Mozzie-AU/LeafOBC-WafflePlate/hardware/README.md

# Hardware

- `original-module/`: KiCad schematic of the original waffle plate, reverse-engineered. See [docs/schematic-notes.md](../docs/schematic-notes.md).
- `replica-altium/`: Angel Monera Martinez's Altium replica design (built, untested). See its [README](replica-altium/README.md).
