Mozzie-AU/LeafOBC-WafflePlate/docs/full-bridge-gate-drive.md

# Primary full bridge: gate network

Work in progress on the gate-drive network around the eight full-bridge IGBTs (section C of the schematic). Everything here comes from **copper traced in the stitched image** of the laser-stripped module. On that module every semiconductor is shorted, resistors are open and the capacitors are degraded. So:

- **Connections** can be confirmed with a meter, but only between copper points that no part bridges.
- **Part values and types** can't be measured on this module. They are listed from references until a second unit is available.

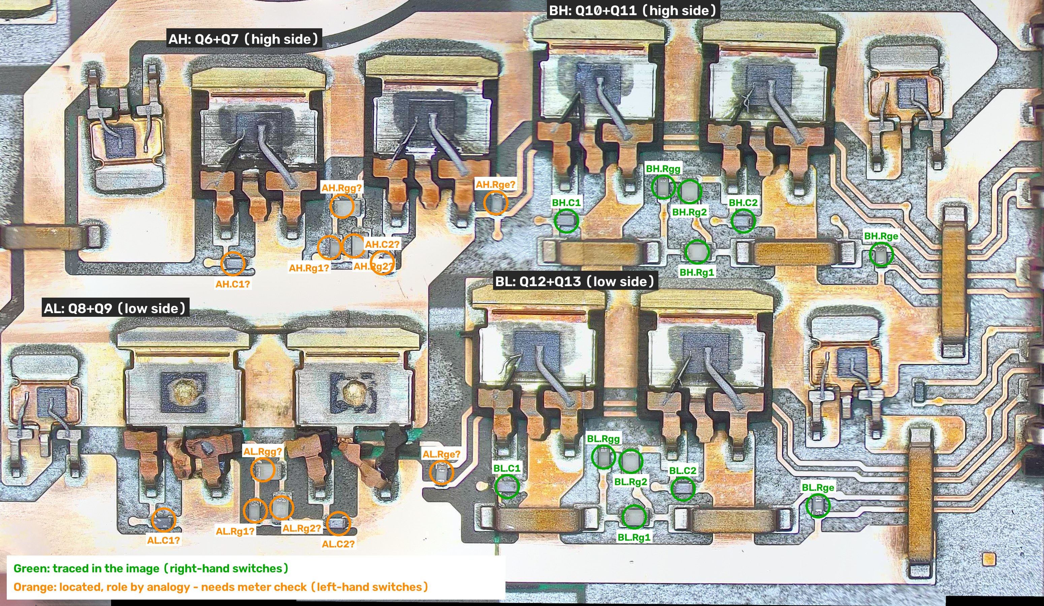
[picture p4: images/annotated/full-bridge-gate-map.jpg]
Full-bridge gate network map


*Crop of [`images/stitched/waffle-plate-top.jpg`](../images/stitched/waffle-plate-top.jpg), x 1850–4950, y 2950–4750. Green circles are parts whose connections were traced in the image. Orange circles are parts located but assigned by analogy, so they need a meter check.*

## Switches and legs

Read from where the IGBT tabs (collectors) and emitter leads sit on the copper:

| Switch | IGBTs | Collector (tab) on | Emitter on | Freewheel diode |
|---|---|---|---|---|
| **AH**: leg A high side | Q6, Q7 (top-left) | top HV_BUS+ copper | leg A midpoint (large cream area, left) | D7 |
| **AL**: leg A low side | Q8, Q9 (bottom-left) | leg A midpoint | bottom rail (HB_N) | D8 |
| **BH**: leg B high side | Q10, Q11 (top-right) | top HV_BUS+ copper | leg B midpoint (vertical copper column) | D9 |
| **BL**: leg B low side | Q12, Q13 (bottom-right) | leg B midpoint | bottom rail (HB_N) | D10 |

This matches the provisional assignment already in the schematic.

On each IGBT, the **left** lead has the thin bond wire (**gate**). The **right** lead has the thick bond wire (**emitter**). The middle lead is trimmed, because the collector is the tab.

The freewheel diodes have bond wires to **both** outer leads, so both outer leads are the anode, and the tab is the cathode.

## Gate network per switch

The two right-hand switches (BH, BL) have identical copper layouts, one shifted about 800 px below the other. Both were traced in full. Each has six small parts:

| Part | Connects | Role | Ukrainian schematic | Reference value |
|---|---|---|---|---|
| **Rg1** | drive input ↔ gate of IGBT 1 (via the left jumper) | gate resistor | R210 | 10 Ω |
| **Rg2** | drive input ↔ gate of IGBT 2 | gate resistor | R212 | 10 Ω |
| **Rgg** | gate 1 ↔ gate 2 | resistor between the two gates | R211 | 10 Ω |
| **C1** | gate 1 ↔ emitter (beside the gate lead) | gate–emitter capacitor | C210 | 1 nF |
| **C2** | gate 2 ↔ emitter | gate–emitter capacitor | C211 | 1 nF |
| **Rge** | drive input ↔ emitter rail; a second track from the same end runs to the module pins | drive-input pull-down; emitter (Kelvin) return | R213 | 1 kΩ |

```
 drive in (pad) ──┬──[Rg1]──┬── gate IGBT1 ──[C1]── emitter
                  │       [Rgg]
                  ├──[Rg2]──┴── gate IGBT2 ──[C2]── emitter
                  └──[Rge]────────────────────────── emitter ──→ Kelvin return (pad)
```

This reproduces the Ukrainian schematic exactly, including its unusual 10 Ω between the gates. That's now confirmed by the copper, not just the drawing.

The roles of C1/C2 versus Rge come from where they connect. On this module the parts can't tell us whether a given chip is a resistor or a capacitor. The values in the table are the Ukrainian schematic's and are **unconfirmed**.

### Layout notes

- The gate-drive input and the far-side gate cross the big copper (the midpoint column, or the emitter copper) on the **horizontal copper jumpers** at y ≈ 3700 (BH) and y ≈ 4490 (BL).
- The drive-input and Kelvin-return tracks run right, **under the vertical jumpers** at x ≈ 4570–4650, to the module pins on the right edge.
- Each gate node has a small round test pad: BH at (3445, 3600) and (3977, 3606); BL at the corresponding spots.

## Part positions

Pixel positions in the stitched image.

| Switch | Rg1 | Rg2 | Rgg | C1 | C2 | Rge |
|---|---|---|---|---|---|---|
| BH (traced) | (3920, 3698) | (3898, 3519) | (3820, 3505) | (3532, 3606) | (4057, 3606) | (4467, 3705) |
| BL (traced) | (3733, 4485) | (3723, 4320) | (3642, 4307) | (3356, 4395) | (3878, 4402) | (4279, 4452) |
| AH (by analogy) | (2828, 3685)? | (2900, 3680)? | (2865, 3562)? | (2541, 3733)? | (2985, 3730)? | (3322, 3552)? |
| AL (by analogy) | (2608, 4467)? | (2686, 4458)? | (2630, 4345)? | (2336, 4494)? | (2855, 4505)? | (3161, 4353)? |

For the left-hand switches, what the image does show:

- **AH:** C1 sits beside Q6's gate lead and C2 beside Q7's. The two "Rg" parts share a bottom track (the drive input), and Rgg joins their tops.
- **AL:** the parts sit in the same pattern.

Which gate each Rg feeds hasn't been traced yet.

## Damage

- **AL (Q8, Q9) failed and ruptured.** Their leads and "pigtails" are burnt and partly melted, with green residue next to Q9, and the two dies show a round spot in the middle. Their lead shapes **don't represent the real die structure**, so don't use them to identify gate or emitter.
- **Some gate terminations on the other dies were damaged** during handling. The gate/emitter identification (thin bond wire to the left lead = gate, thick to the right = emitter) is consistent across the dies that are intact, and agrees with both the Ukrainian schematic and Angel's design. Still, treat any single die's bond wires with care.

## Comparison with Angel's replica design

Angel's `igbt pair` sub-sheet (in [`hardware/replica-altium/kicad/`](../hardware/replica-altium/kicad/)) has **exactly the traced topology** for each of the four switches:

| Traced role | Angel's part | Value |
|---|---|---|
| Rg1: drive → gate 1 | R10 | 10 Ω |
| Rg2: drive → gate 2 | R12 | 10 Ω |
| Rgg: gate 1 ↔ gate 2 | R11 | 10 Ω |
| C1: gate 1 → emitter | C3 | 1 nF |
| C2: gate 2 → emitter | C2 | 1 nF |
| Rge: drive → emitter | R13 | 1 kΩ |

So three sources agree on the **topology**: the copper, the Ukrainian schematic and Angel's design. They aren't independent sources for the **values**, because Angel's values match the Ukrainian schematic and were probably taken from it.

(Angel's PFC driver had the transistors' emitter and collector swapped; see [PFC gate driver](pfc-gate-driver.md). His full-bridge gate network doesn't have that problem.)

## Are the values reasonable? (datasheet check)

There is **no public RJP6012 datasheet**. Renesas has said all its IGBTs are end-of-life ([Renesas community thread](https://community.renesas.com/power-products/f/power-management/58643/rjp6012-datasheet)). As a stand-in, the [RJP60V0DPM](https://www.mouser.com/datasheet/2/698/r07ds0669ej0200_rjp60v0dpm-1093090.pdf) is a 600 V, 22 A Renesas IGBT from the same RJP60 family. For Angel's part, the [HGTG10N120BND](https://www.mikrocontroller.net/attachment/132171/10n120bnd.pdf) datasheet covers the same 1200 V NPT IGBT as the HGT1S10N120BNS, plus an internal diode.

| | RJP60V0DPM | HGTG10N120BND |
|---|---|---|
| V(GE) max | ±30 V | ±20 V (±30 V pulsed) |
| Cies | 1080 pF | not stated |
| Qg at 15 V | 75 nC | 100 nC |
| Switching test R(G) | 5 Ω | 10 Ω |
| t(f) | 70 ns | 100–140 ns |

Against those figures:

- **10 Ω per gate (Rg1, Rg2):** the same order as the datasheet test resistors (5–10 Ω). Reasonable.
- **1 nF gate–emitter (C1, C2):** about the same as the IGBT's own input capacitance (~1.1 nF), so it roughly doubles the gate load. With 10 Ω the gate time constant is about 20 ns. That slightly slows the switching edges and reduces Miller-induced turn-on (Cres is only ~42 pF). It adds about 15 nC per IGBT at 15 V, roughly +20 % driver load. Reasonable for a few-tens-of-kHz bridge.
- **10 Ω between the two gates (Rgg):** unusual. With separate gate resistors already present, it looks intended to tie the two paralleled gates together and damp oscillation between them. It's harmless at this value.
- **1 kΩ drive-input pull-down (Rge):** a normal value for holding the gates off when the driver is unpowered.
- **Gate drive voltage:** set by the charger board's gate driver and **not yet known**. It must stay within V(GE) max, and Angel's part has the tighter rating (±20 V).

**For a replica:** Angel's HGT1S10N120BNS is a 1200 V NPT IGBT with higher gate charge (100 nC against 75 nC) and a slower fall time. It's over-rated for a ~400 V bus, and it will run with more switching loss than a 600–650 V part. Worth comparing with current 600–650 V IGBTs before committing.

## Gate-drive pads

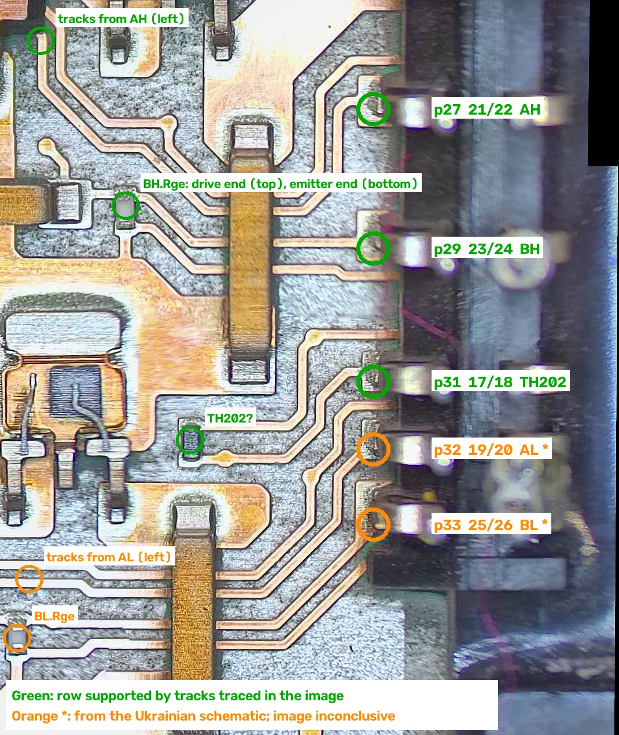
[picture p5: images/annotated/gate-drive-pads.jpg]
Gate-drive pad rows on the right edge


*Crop of the stitched image, x 4250–5320, y 3350–4620. Circles on the right mark the module-side pad of each pin row.*

The lower right edge has seven pin rows. Each row has an **inner** pin, whose pad the tracks reach, and an **outer** pin. That fits the draft and the Ukrainian schematic naming each pad as a pin pair ("21/22" and so on). From top to bottom the rows match the draft's pads in order: p23 (T1), p25 (T4), p27, p29, p31, p32, p33.

Each switch's two tracks (drive input and emitter return) run as a pair to one row:

| Row (y) | Draft pad | Pins | Switch | Drive pin | Emitter (Kelvin) pin | Evidence |
|---|---|---|---|---|---|---|
| 3538 | p27 | 21/22 | **AH** | 22 | 21 (BR_A) | Image: the pair of tracks from the left-hand switches lands on this row |
| 3779 | p29 | 23/24 | **BH** | 23 | 24 (BR_B) | Image: the DRV_BH track lands on the inner pad. The emitter track from BH.Rge runs to the same row |
| 4009 | p31 | 17/18 | — | — | — | Image: a small chip at (4578, 4110) sits across this row's two pins. This is TH202, the 100 k thermistor on the Ukrainian schematic |
| 4126 | p32 | 19/20 | **AL** \* | 19 | 20 (HB_N) | Ukrainian schematic only |
| 4256 | p33 | 25/26 | **BL** \* | 25 | 26 (HB_N) | Ukrainian schematic only |

\* For the bottom two rows, the AL and BL track pairs run under the lower vertical jumper and cross on their way up to the pins. In the image I couldn't tell which row each pair reaches, so these two follow the Ukrainian schematic.

**Which pin in each pair is drive** is taken from the Ukrainian schematic. The image confirms it for BH only, where the drive track lands on the inner pad. The physical numbering (which of the inner and outer pins is the lower number) isn't known yet.

The two upper rows, p23 (T1) and p25 (T4), are the bridge midpoints to the transformers. Which leg goes to which is still listed as check 5 below.

## Meter checks (copper only)

Probe copper on both sides, never across a part.

1. **BH and BL:** gate test pad ↔ gate lead pad, for each IGBT, to confirm the gate nets.
2. **BH and BL:** each end of the horizontal jumpers ↔ the tracks they join (left end to gate 1, right end to the drive input).
3. **Pad mapping:** confirm the table above. For each switch, continuity from the Rge drive-input end and its emitter (Kelvin) track to the inner and outer pin of its row. AL and BL (p32, p33) need it most.
4. **AH and AL:** for each part, check each end against the gate pads, the emitter copper and the shared drive-input track, to confirm or correct the roles marked "?".
5. **Midpoints:** leg A midpoint (cream area) ↔ pad p23 (T1); leg B midpoint (vertical column) ↔ pad p25 (T4). Or the other way round, which is the point of checking.

## Still needed

- A second, intact module to measure the part values and confirm the part types.
- Confirmation of the pad mapping, especially AL/BL (check 3).
- Confirmation of the left-hand switches (check 4).
- The gate drive voltage from the charger board.

## In the schematic

Section C of [`waffle-plate.kicad_sch`](../hardware/original-module/waffle-plate.kicad_sch) is drawn wired as an H-bridge. Leg A (AH above AL) and leg B (BH above BL) share the HV_BUS+ rail across the top. Each leg's midpoint is a wire (BR_A, BR_B), and the two bottom rails join as HB_N. Each switch's gate network runs from its drive pad to both gates, with its emitter (Kelvin) pad on the emitter rail. Everything in section C is marked `Verified = no`. The parts are:

- **AH:** R11–R14, C11–C12.
- **AL:** R21–R24, C21–C22.
- **BH:** R31–R34, C31–C32.
- **BL:** R41–R44, C41–C42.

Values ending in "?" are the reference values. Each switch has its own drive-input net (`DRV_AH` and so on) and its own gate nets (`G_AH1`, `G_AH2` and so on). Each switch's drive and emitter pads are drawn next to it (P26–P33), marked unconfirmed, with the source noted on each.
