Mozzie-AU/LeafOBC-WafflePlate/hardware/replica-altium/fabrication/2024-10-28-jlcpcb/Report Board Stack/waffle.xls

Board Stack Report
Stack Up |  | Layer Stack
Layer | Board Layer Stack | Name | Material | Thickness | Constant
1 |  | Top Overlay |  | 0mm
2 |  | Top Solder | SM-001 | 0.0254mm | 4
3 |  | Top Surface Finish | PbSn | 0.02mm
4 |  | Top Layer | CF-004 | 0.035mm
5 |  | Dielectric 1 | Core-043 | 1.5mm | 4.3
6 |  | Bottom Layer | CF-004 | 0.035mm
7 |  | Bottom Surface Finish | PbSn | 0.02mm
8 |  | Bottom Solder | SM-001 | 0.0254mm | 4
9 |  | Bottom Overlay |  | 0mm
 | Height : 1.6608mm
