Mozzie-AU/LeafOBC-WafflePlate/images/raw/waffle-plate-top/IMG00000.JPG

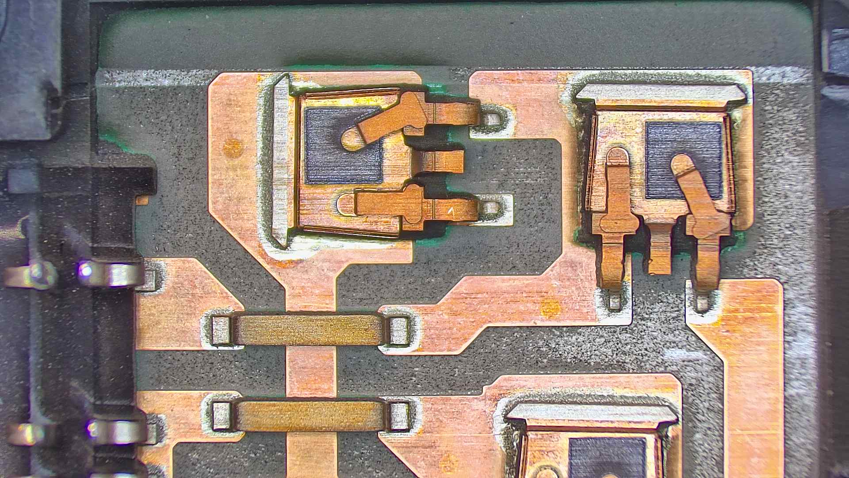
images/raw/waffle-plate-top/IMG00000.JPG
