Mozzie-AU/LeafOBC-WafflePlate/images/raw/waffle-plate-top/IMG00001.JPG

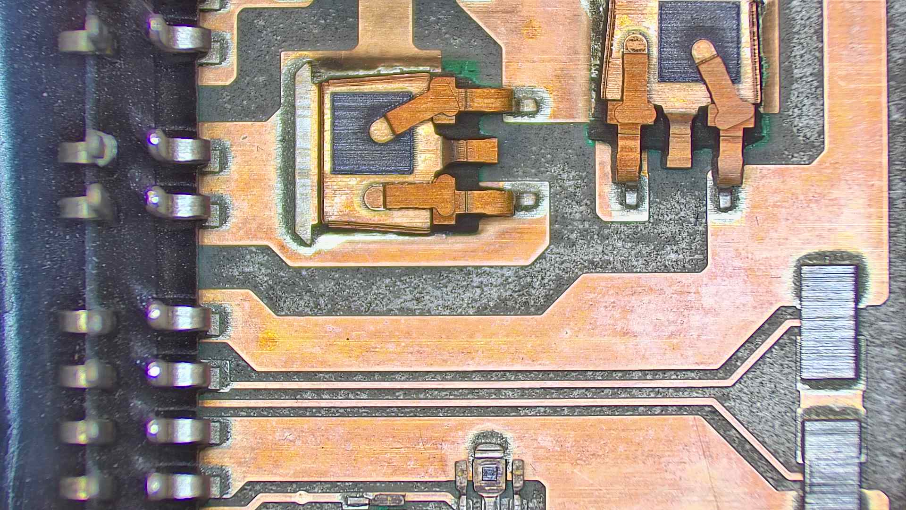
images/raw/waffle-plate-top/IMG00001.JPG
