Mozzie-AU/LeafOBC-WafflePlate/images/raw/waffle-plate-top/IMG00002.JPG

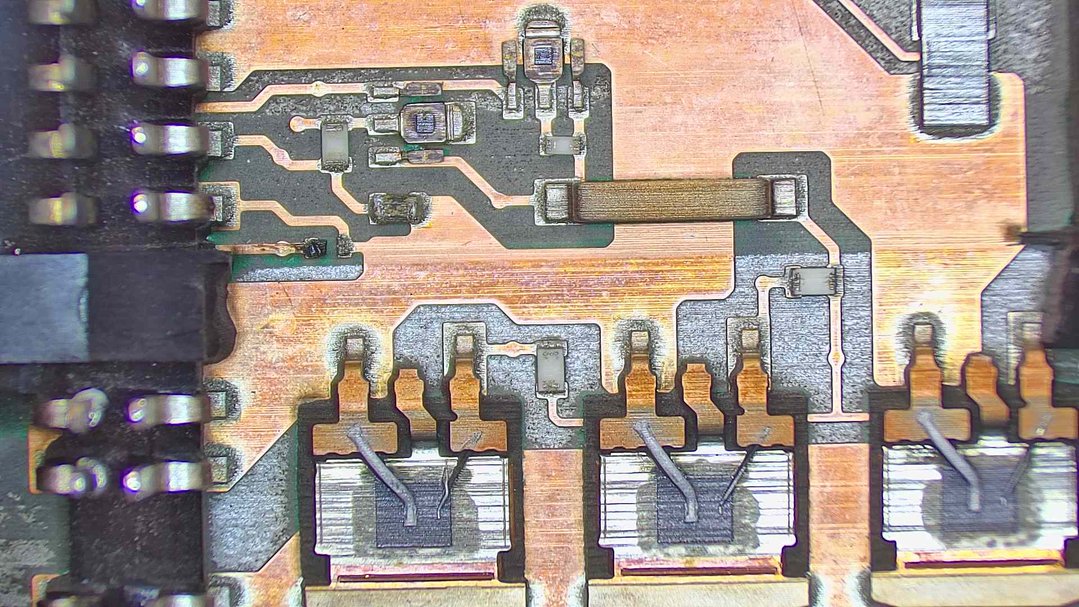
images/raw/waffle-plate-top/IMG00002.JPG
