Mozzie-AU/LeafOBC-WafflePlate/images/raw/waffle-plate-top/IMG00003.JPG

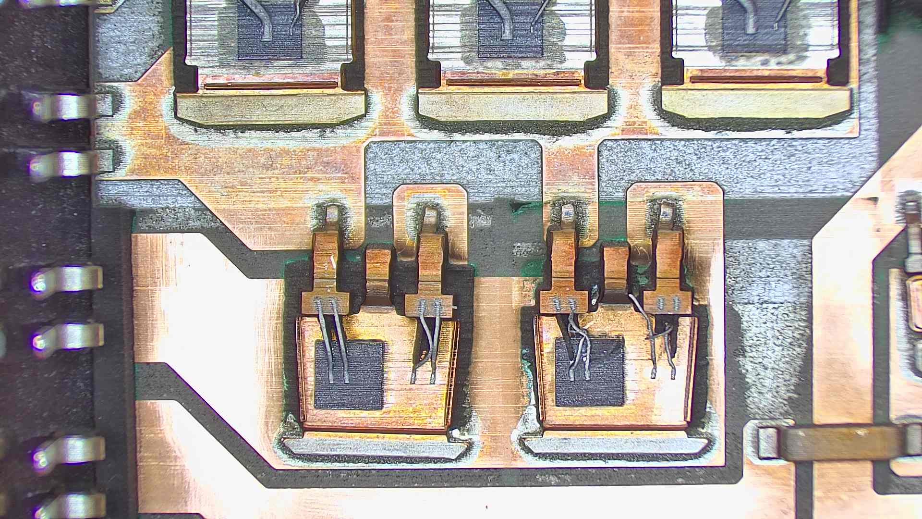
images/raw/waffle-plate-top/IMG00003.JPG
