Mozzie-AU/LeafOBC-WafflePlate/images/raw/waffle-plate-top/IMG00004.JPG

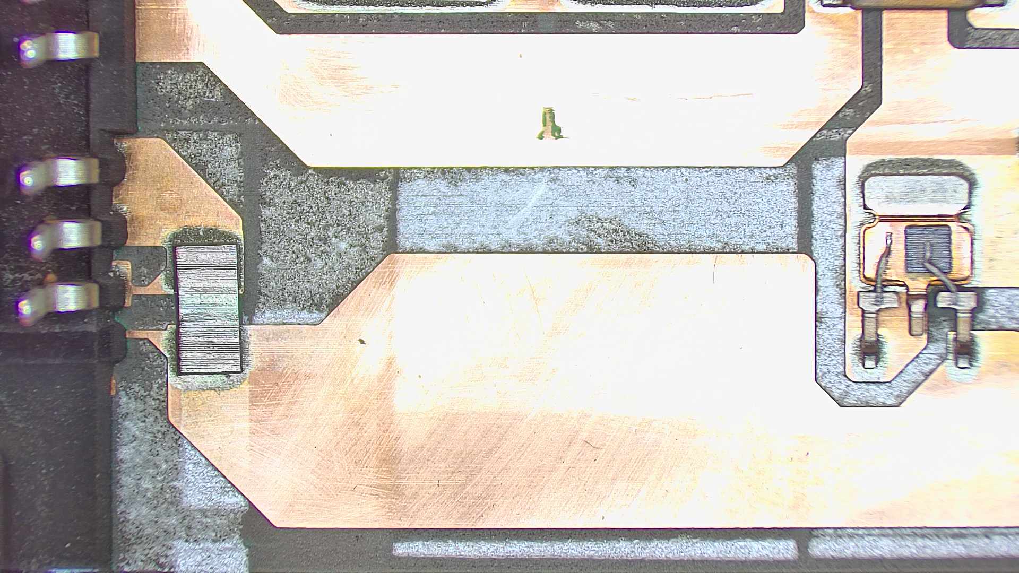
images/raw/waffle-plate-top/IMG00004.JPG
