Mozzie-AU/LeafOBC-WafflePlate/images/raw/waffle-plate-top/IMG00005.JPG

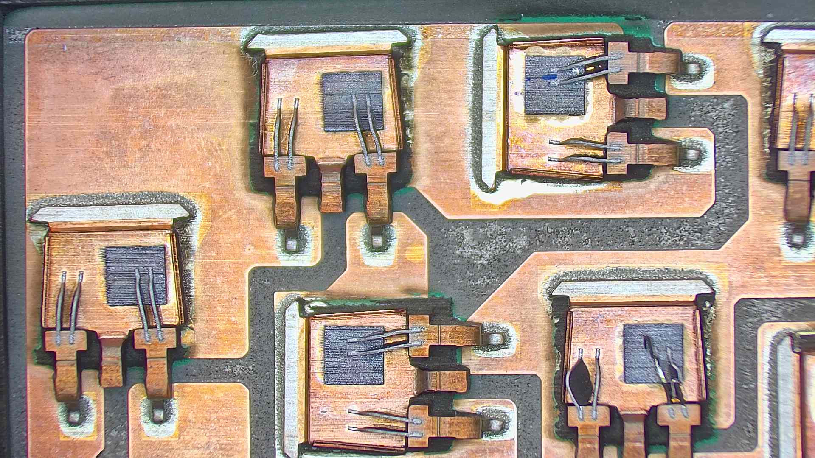
images/raw/waffle-plate-top/IMG00005.JPG
