Mozzie-AU/LeafOBC-WafflePlate/images/raw/waffle-plate-top/IMG00006.JPG

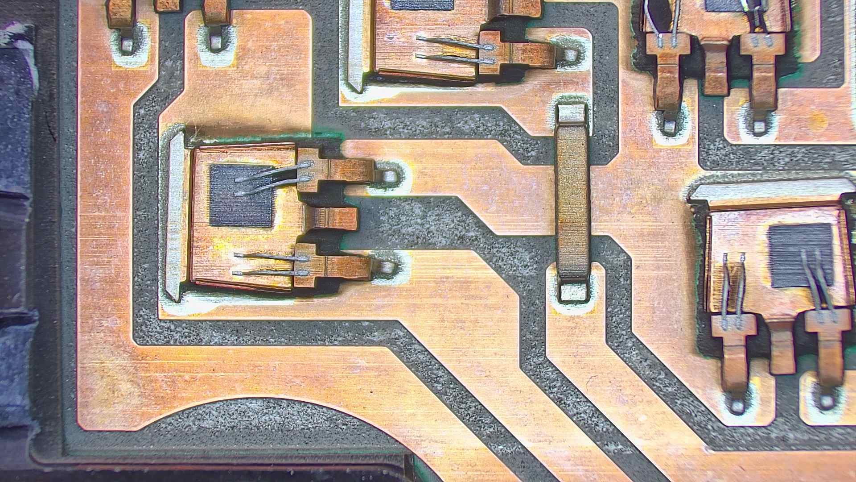
images/raw/waffle-plate-top/IMG00006.JPG
