Mozzie-AU/LeafOBC-WafflePlate/images/raw/waffle-plate-top/IMG00007.JPG

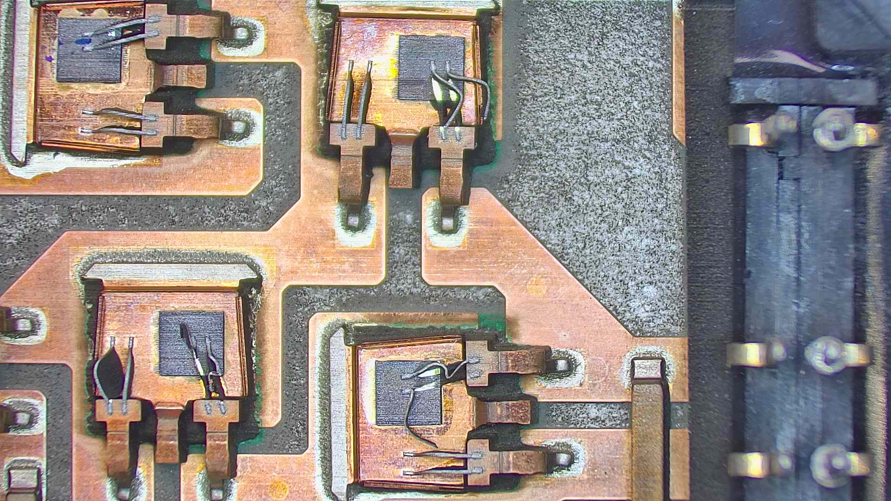
images/raw/waffle-plate-top/IMG00007.JPG
