Mozzie-AU/LeafOBC-WafflePlate/images/raw/waffle-plate-top/IMG00008.JPG

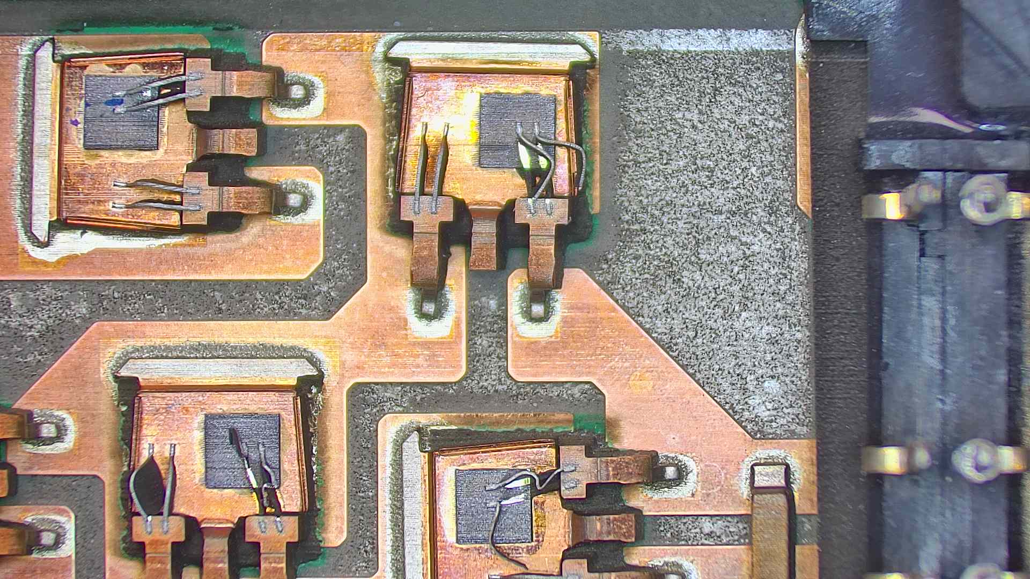
images/raw/waffle-plate-top/IMG00008.JPG
