Mozzie-AU/LeafOBC-WafflePlate/images/raw/waffle-plate-top/IMG00009.JPG

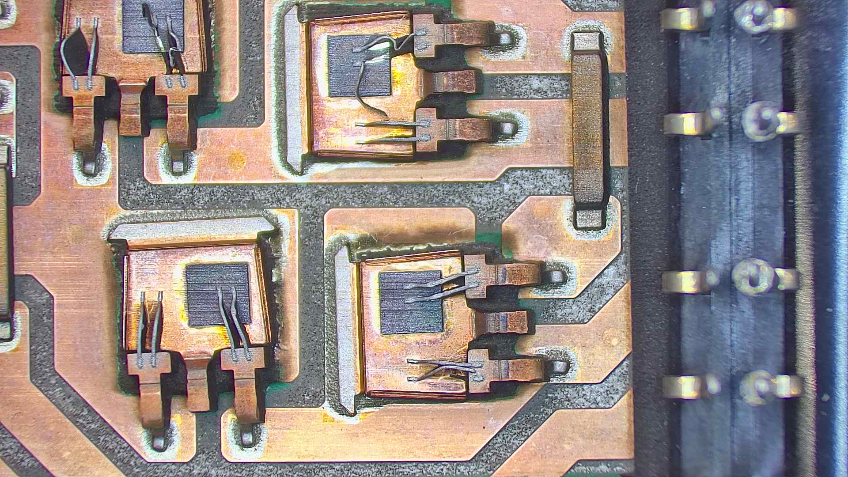
images/raw/waffle-plate-top/IMG00009.JPG
