Mozzie-AU/LeafOBC-WafflePlate/images/raw/waffle-plate-top/IMG00010.JPG

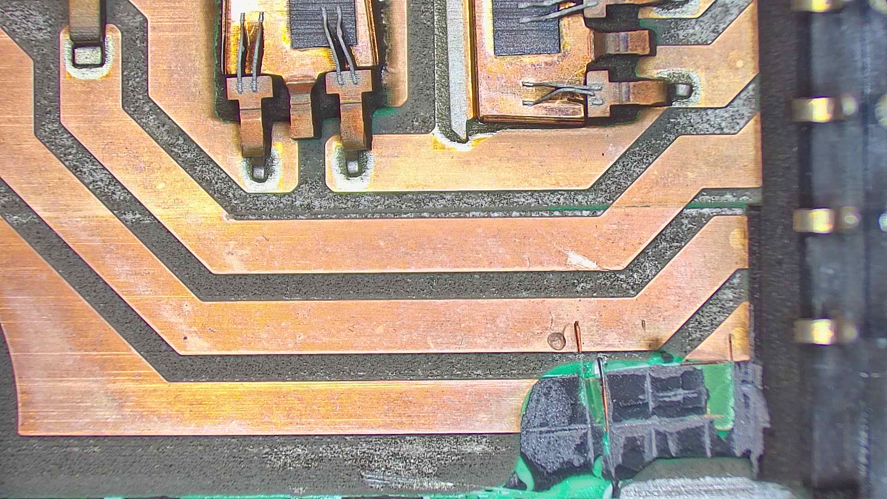
images/raw/waffle-plate-top/IMG00010.JPG
