Mozzie-AU/LeafOBC-WafflePlate/images/raw/waffle-plate-top/IMG00011.JPG

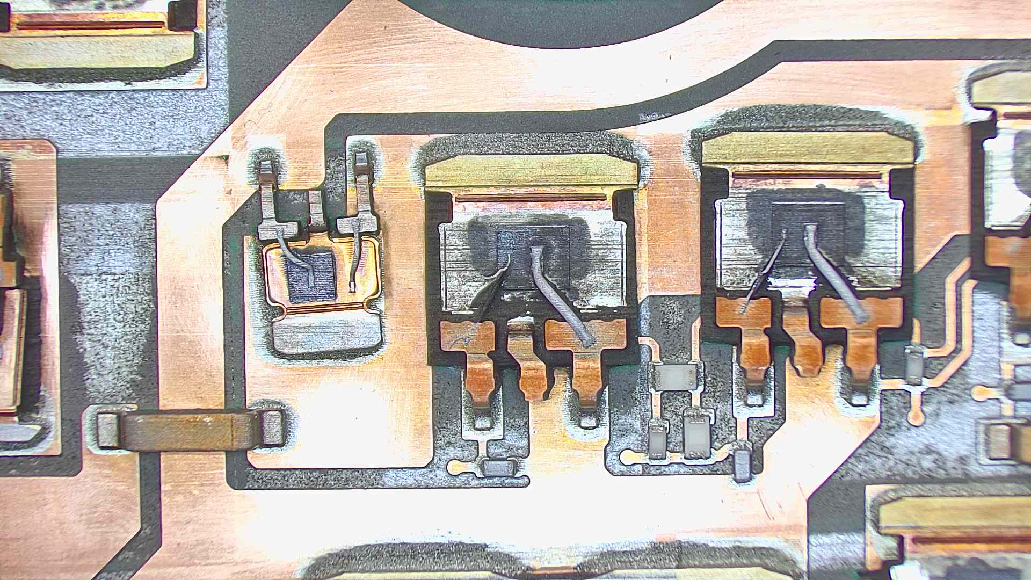
images/raw/waffle-plate-top/IMG00011.JPG
