Mozzie-AU/LeafOBC-WafflePlate/images/raw/waffle-plate-top/IMG00012.JPG

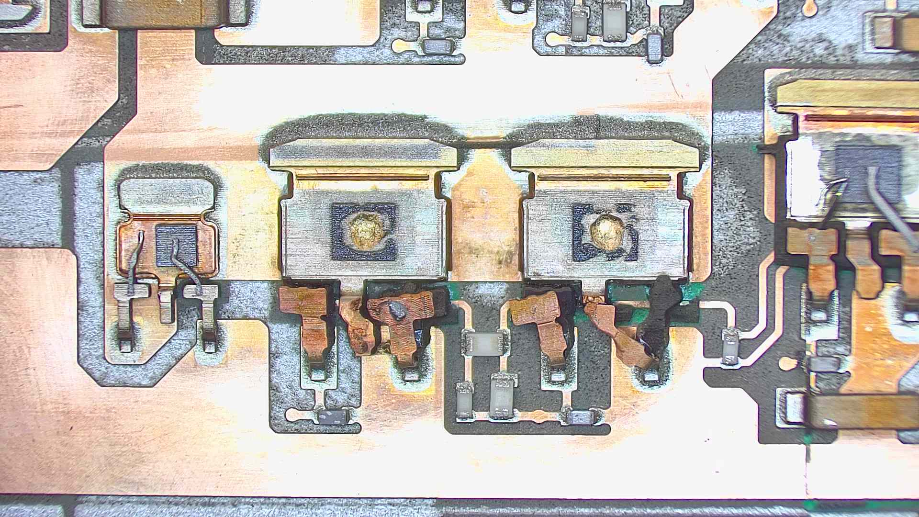
images/raw/waffle-plate-top/IMG00012.JPG
