Mozzie-AU/LeafOBC-WafflePlate/images/raw/waffle-plate-top/IMG00013.JPG

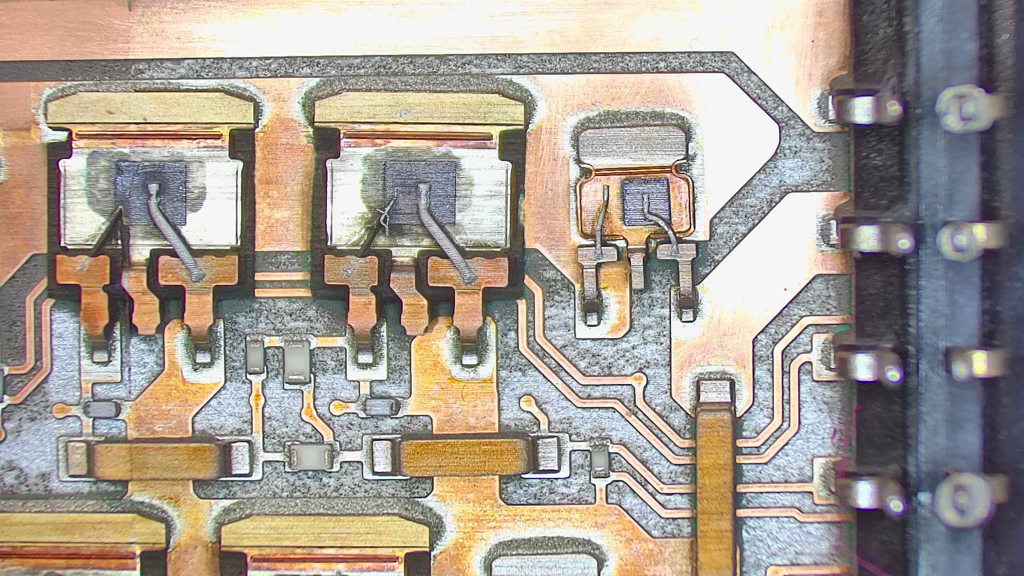
images/raw/waffle-plate-top/IMG00013.JPG
