Mozzie-AU/LeafOBC-WafflePlate/images/raw/waffle-plate-top/IMG00014.JPG

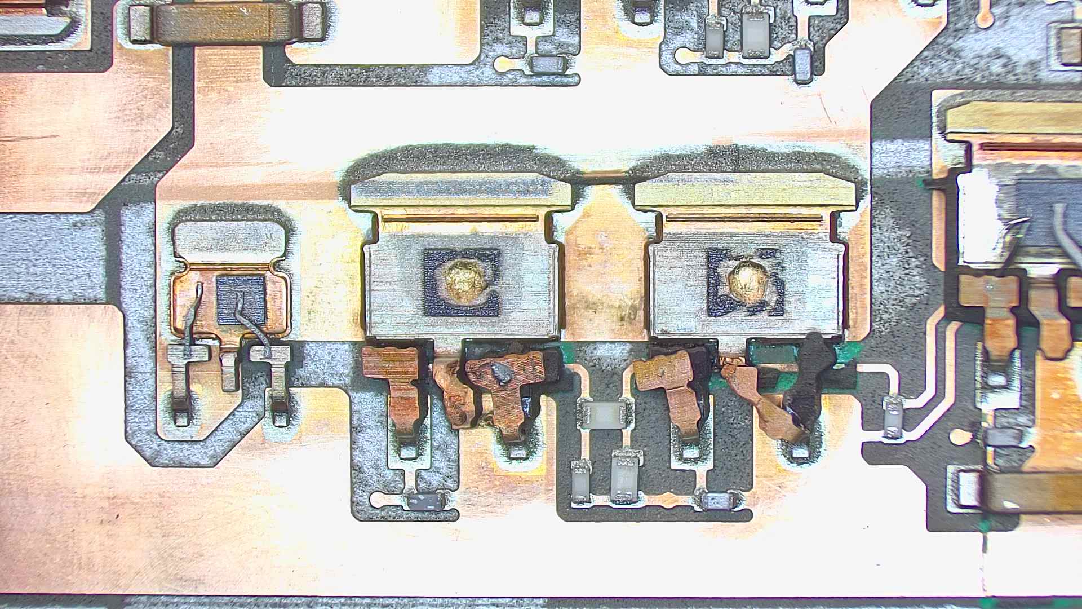
images/raw/waffle-plate-top/IMG00014.JPG
