Mozzie-AU/LeafOBC-WafflePlate/images/raw/waffle-plate-top/IMG00015.JPG

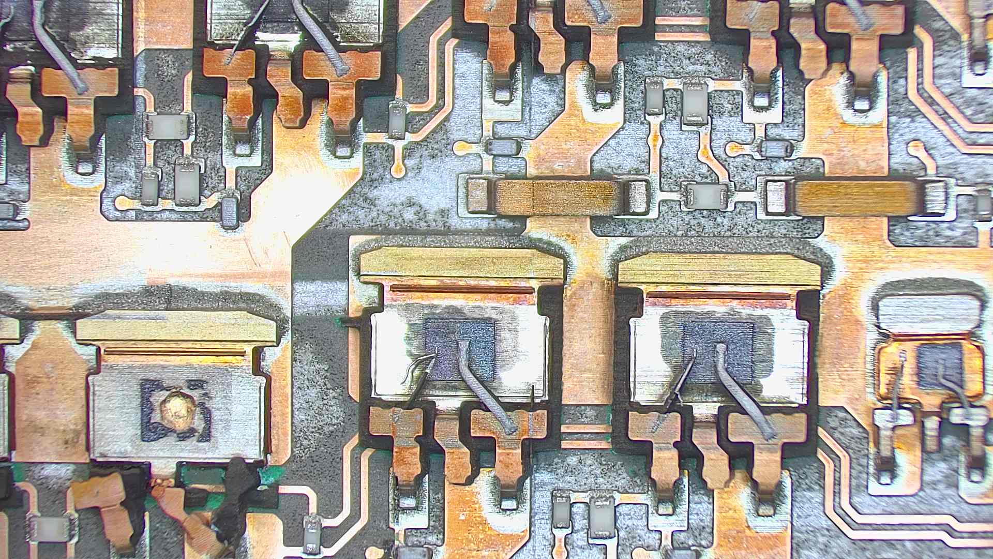
images/raw/waffle-plate-top/IMG00015.JPG
