Mozzie-AU/LeafOBC-WafflePlate/images/raw/waffle-plate-top/IMG00016.JPG

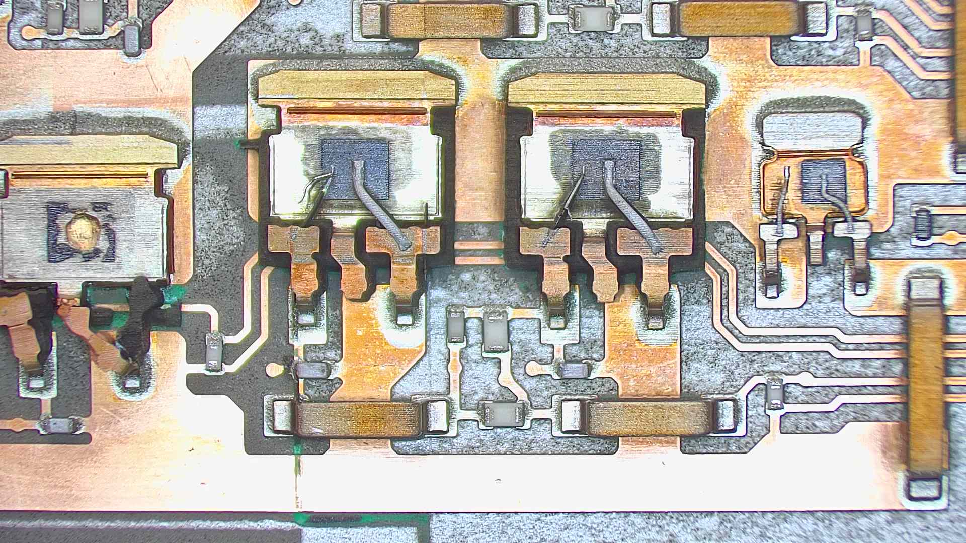
images/raw/waffle-plate-top/IMG00016.JPG
