Mozzie-AU/LeafOBC-WafflePlate/images/raw/waffle-plate-top/IMG00017.JPG

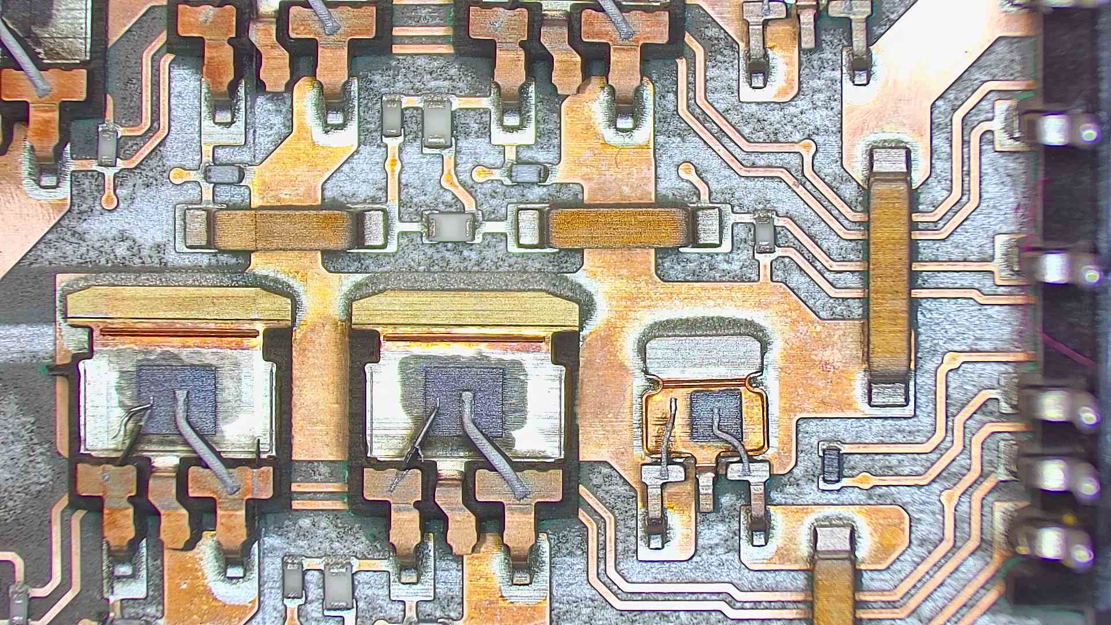
images/raw/waffle-plate-top/IMG00017.JPG
