Mozzie-AU/LeafOBC-WafflePlate/images/raw/waffle-plate-top/IMG00018.JPG

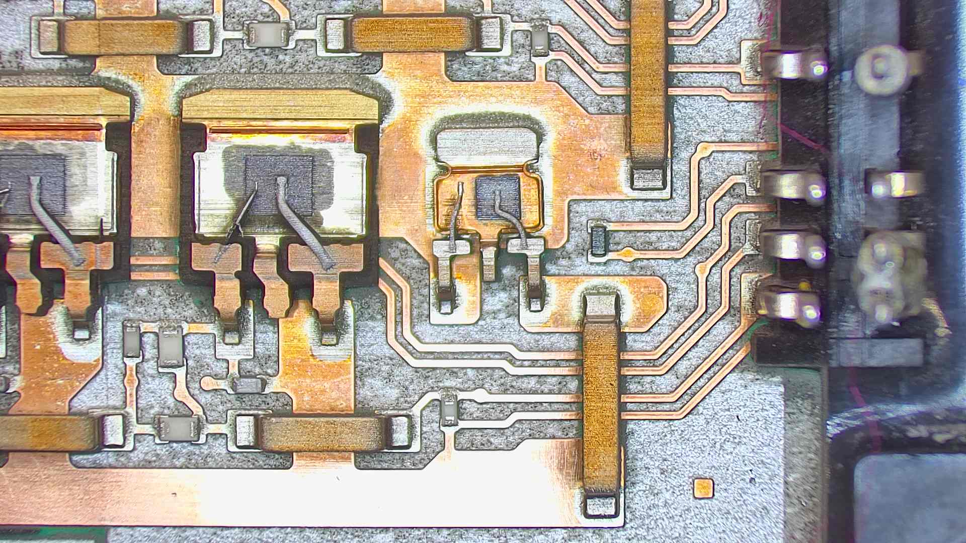
images/raw/waffle-plate-top/IMG00018.JPG
