Mozzie-AU/LeafOBC-WafflePlate/images/raw/waffle-plate-top/IMG00019.JPG

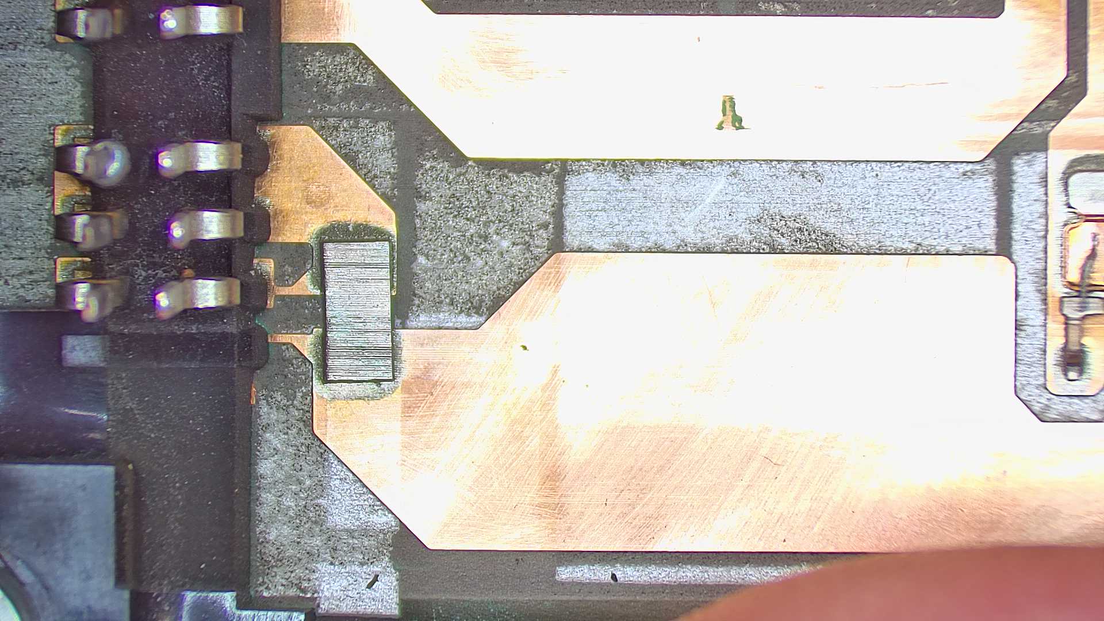
images/raw/waffle-plate-top/IMG00019.JPG
