Mozzie-AU/LeafOBC-WafflePlate/images/raw/waffle-plate-top/IMG00020.JPG

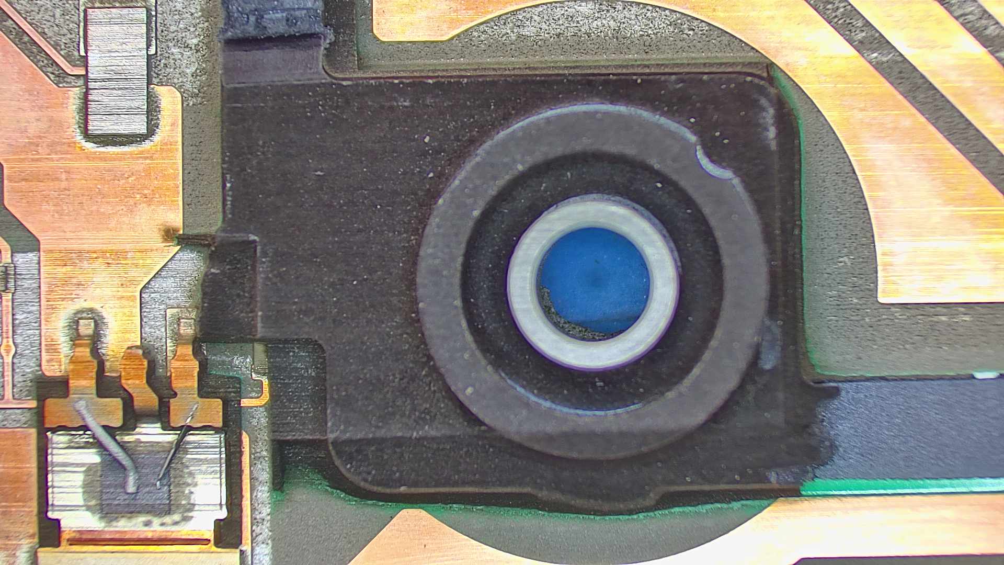
images/raw/waffle-plate-top/IMG00020.JPG
