Mozzie-AU/LeafOBC-WafflePlate/docs/component-inventory.md

# Component inventory

One row per component. Reference designators are assigned in this project; the original has none visible. Coordinates are pixel positions (x, y) in [`images/stitched/waffle-plate-top.jpg`](../images/stitched/waffle-plate-top.jpg).

| Ref | Region | Type (guess) | Markings | Position (px) | Notes |
|---|---|---|---|---|---|
| Q1 | Upper left | | | | |
| Q2 | Upper left | | | | |

## Conventions

- `Q` = transistor die, `D` = diode die, `R`/`C` = passives, `J` = connector pin, `L` = bridging link
- Number regions in this order: top-left, middle-left, lower-left, upper-right, lower-right. Within each region, number left to right, then top to bottom.
