Mozzie-AU/LeafOBC-WafflePlate/hardware/replica-altium/fabrication/2024-10-28-jlcpcb/BOM/Bill of Materials-Nissan Leaf Waffle.xlsx

Comment | Designator | Footprint | Description | Quantity | Supplier 1 | Supplier Part Number 1
1uF | C1 | 1206 | 1206 1UF 50V | 1
1nF | C2NE, C2NW, C2SE, C2SW, C3NE, C3NW, C3SE, C3SW | 1206 | CAPACITOR 1nF 1206 | 8
SE20DLJ-M3/I | D1, D2, D3, D4, D5, D6, D7, D8, D9, D10, D11, D12, D13, D14, D15, D16, D17NE, D17NW, D17SE, D17SW | PG-TO252-3 - diode | Diode rectifier 1V/1A/700V, SE20DLJ-M3/I | 20 | Digikey, Mouser | 112-VS-E5TX3012S2L-M3CT-ND, 78-VS-E5TX3012S2L-M3
connector_waffle | J1 | waffle |  | 1
BCX53-16 | Q1 | SOT-89 | BCX53-16 PNP | 1 | Mouser | 726-BCX5316H6327XTSA
BCX56-16 | Q2 | SOT-89 | BCX56-16 NPN | 1 | Mouser | 726-BCX5616H6327XTSA
HGT1S10N120BNST | Q3, Q4, Q5, Q6NE, Q6NW, Q6SE, Q6SW, Q7NE, Q7NW, Q7SE, Q7SW | PG-TO252-3 | IGBT N type 20A(40) 600V dpakpossible replacement STB27NM60ND FGB20N60SF RJP6012, HGT1S10N120BNST IGBT N type 20A(40) 600V dpakpossible replacement STB27NM60ND FGB20N60SF RJP6012 | 11 | Rs | 8076660P
1mOHM | R1, R9 | 1206 | resistor 1206 1mohm. | 2
10K | R2 | 1206 | resistor 10K 1206 | 1
43R | R3 | 1206 | resistor 43R 1206 | 1
NB20N50104JBA | R4, R8 | 1206 | NB20N50104JBA: resistor NTC 100K | 2
39R | R5, R6, R7 | 1206 | resistor 39R 1206 | 3
10R | R10NE, R10NW, R10SE, R10SW, R11NE, R11NW, R11SE, R11SW, R12NE, R12NW, R12SE, R12SW | 1206 | resistor | 12
1K | R13NE, R13NW, R13SE, R13SW | 1206 | resistor 1k 1206 | 4
