Mozzie-AU/LeafOBC-WafflePlate/hardware/replica-altium/kicad/ALTIUM_EMBEDDED_MODELS/p204_SOT-89.stp

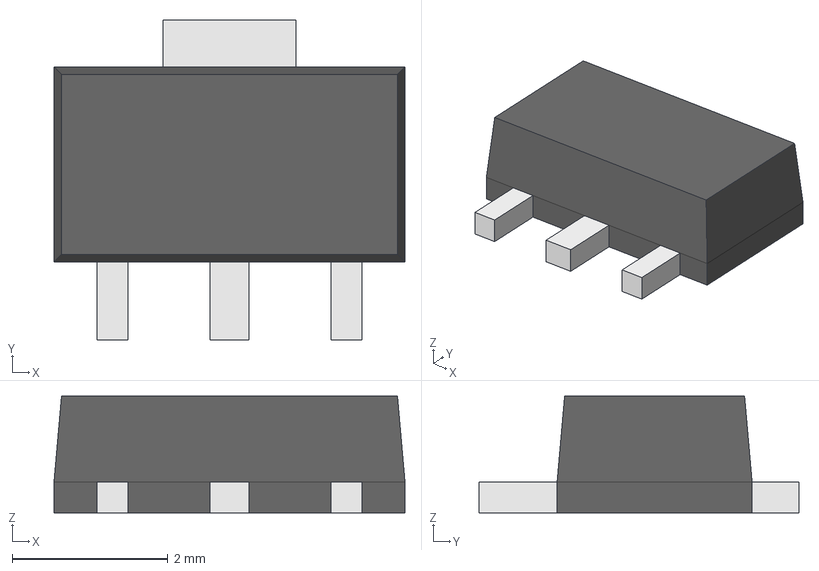
[picture p35: CAD file, 2026-10-25]
hardware/replica-altium/kicad/ALTIUM_EMBEDDED_MODELS/p204_SOT-89.stp
4.50 x 4.10 x 1.50 mm
