Mozzie-AU/LeafOBC-WafflePlate/hardware/replica-altium/fabrication/2024-10-28-jlcpcb/DRC/waffle.html

Altium

# Design Rule Verification Report

Date: | | 2024-10-27
Time: | | 19:36:41
Elapsed Time: | | 00:00:00
Filename: | | D:\Dropbox\Projects\nissan_leaf_waffle\Nissan Leaf Waffle 2024-10-27\waffle.PcbDoc

Warnings: | | 0
Rule Violations: | | 6

## Summary

Warnings | Count
Total | 0

Rule Violations | Count
Clearance Constraint (Gap=1.2mm) (InNetClass('HV_CLASS')),(All) | 6
Clearance Constraint (Gap=0.2mm) (All),(All) | 0
Short-Circuit Constraint (Allowed=No) (All),(All) | 0
Un-Routed Net Constraint ( (All) ) | 0
Modified Polygon (Allow modified: No), (Allow shelved: No) | 0
Width Constraint (Min=0.5mm) (Max=1mm) (Preferred=1mm) (OnLayer('Top Layer')) | 0
Width Constraint (Min=0.2mm) (Max=10mm) (Preferred=2mm) (OnLayer('Bottom Layer')) | 0
Width Constraint (Min=1mm) (Max=20mm) (Preferred=2mm) (All) | 0
Power Plane Connect Rule(Direct Connect )(Expansion=0.508mm) (Conductor Width=0.254mm) (Air Gap=0.254mm) (Entries=4) (All) | 0
Hole Size Constraint (Min=0.5mm) (Max=10mm) (All) | 0
Hole To Hole Clearance (Gap=0.254mm) (All),(All) | 0
Minimum Solder Mask Sliver (Gap=0.1mm) (All),(All) | 0
Silk To Solder Mask (Clearance=0.1mm) (IsPad),(All) | 0
Silk to Silk (Clearance=0.1mm) (All),(All) | 0
Net Antennae (Tolerance=0mm) (All) | 0
Room se (Bounding Region = (332.8mm, 430.9mm, 370.8mm, 448.9mm) (InComponentClass('se')) | 0
Room sw (Bounding Region = (287.1mm, 434.3mm, 326mm, 454.1mm) (InComponentClass('sw')) | 0
Room waffle (Bounding Region = (242.5mm, 425.6mm, 395.5mm, 564.3mm) (InComponentClass('waffle')) | 0
Room ne (Bounding Region = (333mm, 453.2mm, 366.3mm, 470mm) (InComponentClass('ne')) | 0
Room nw (Bounding Region = (287.3mm, 453.8mm, 325mm, 469.4mm) (InComponentClass('nw')) | 0
Height Constraint (Min=0mm) (Max=25.4mm) (Prefered=12.7mm) (All) | 0
Total | 6

Clearance Constraint (Gap=1.2mm) (InNetClass('HV_CLASS')),(All)

Clearance Constraint: (0.9mm < 1.2mm) Between Pad Q1-2(-54.75mm,17.2mm) on Top Layer And Pad Q1-3(-54.85mm,15.7mm) on Top Layer

Clearance Constraint: (0.755mm < 1.2mm) Between Pad Q1-2(-54.75mm,17.2mm) on Top Layer And Track (-54.905mm,14.445mm)(-54.905mm,15.645mm) on Top Layer

Clearance Constraint: (0.632mm < 1.2mm) Between Pad Q1-3(-54.85mm,15.7mm) on Top Layer And Region (0 hole(s)) Top Layer

Clearance Constraint: (0.95mm < 1.2mm) Between Pad Q1-3(-54.85mm,15.7mm) on Top Layer And Track (-54.75mm,17.2mm)(-48.5mm,17.2mm) on Top Layer

Clearance Constraint: (0.851mm < 1.2mm) Between Region (0 hole(s)) Top Layer And Track (-54.905mm,14.445mm)(-54.905mm,15.645mm) on Top Layer

Clearance Constraint: (0.813mm < 1.2mm) Between Track (-54.75mm,17.2mm)(-48.5mm,17.2mm) on Top Layer And Track (-54.905mm,14.445mm)(-54.905mm,15.645mm) on Top Layer

Back to top
