Mozzie-AU/LeafOBC-WafflePlate/hardware/original-module/waffle-plate.pdf

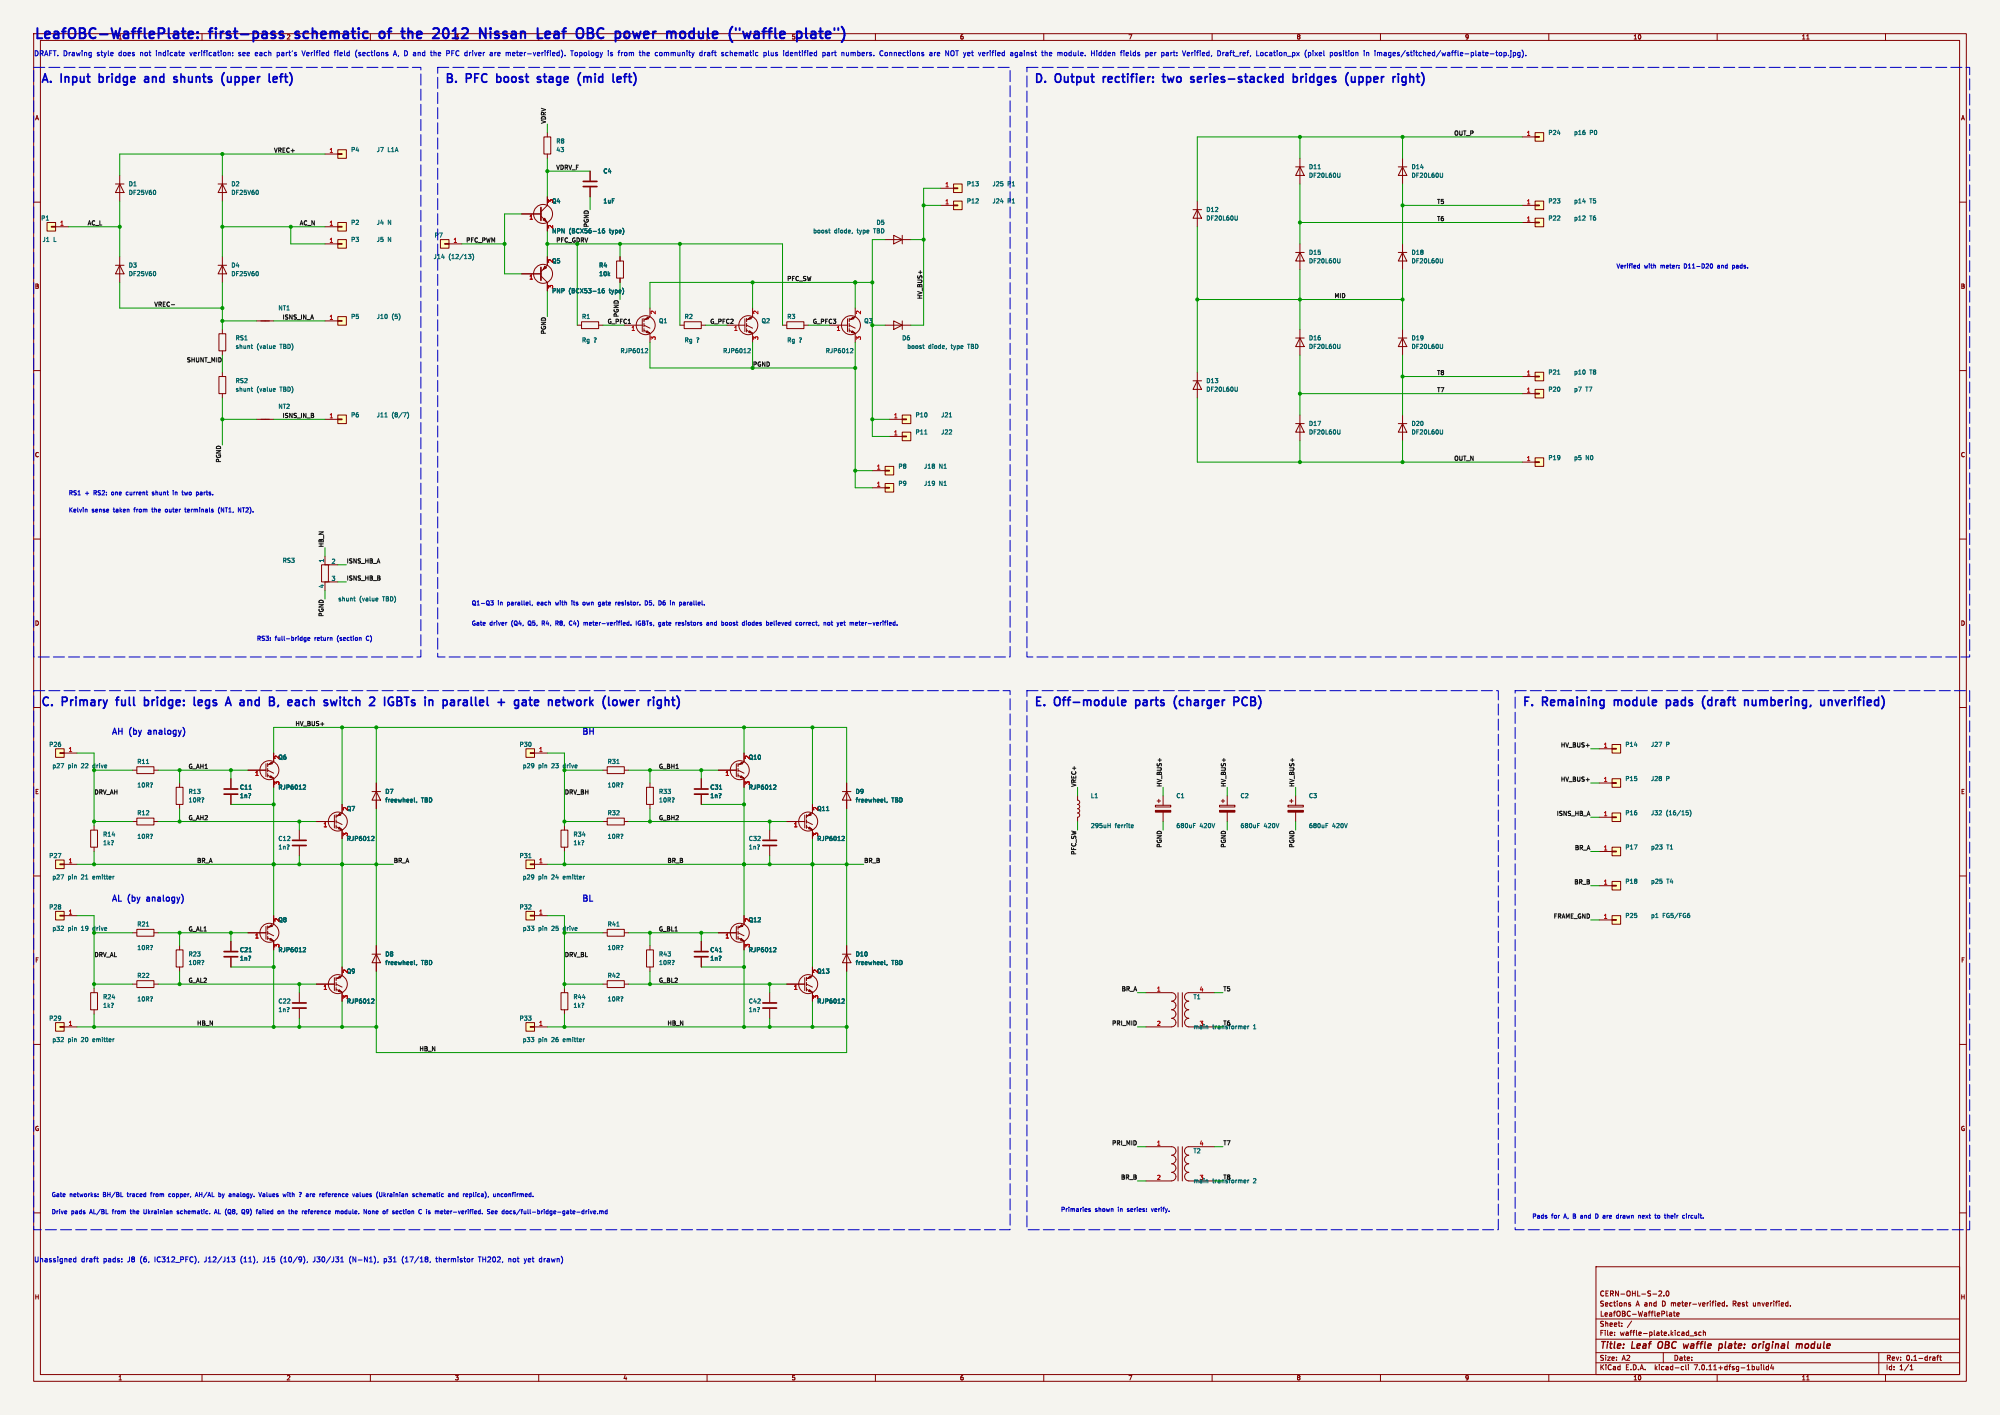
[picture p36: page 1]

2 3 Q3 RJP6012 D5
boost diode, type TBD
