Mozzie-AU/LeafOBC-WafflePlate/hardware/replica-altium/kicad/waffle-schematic.pdf

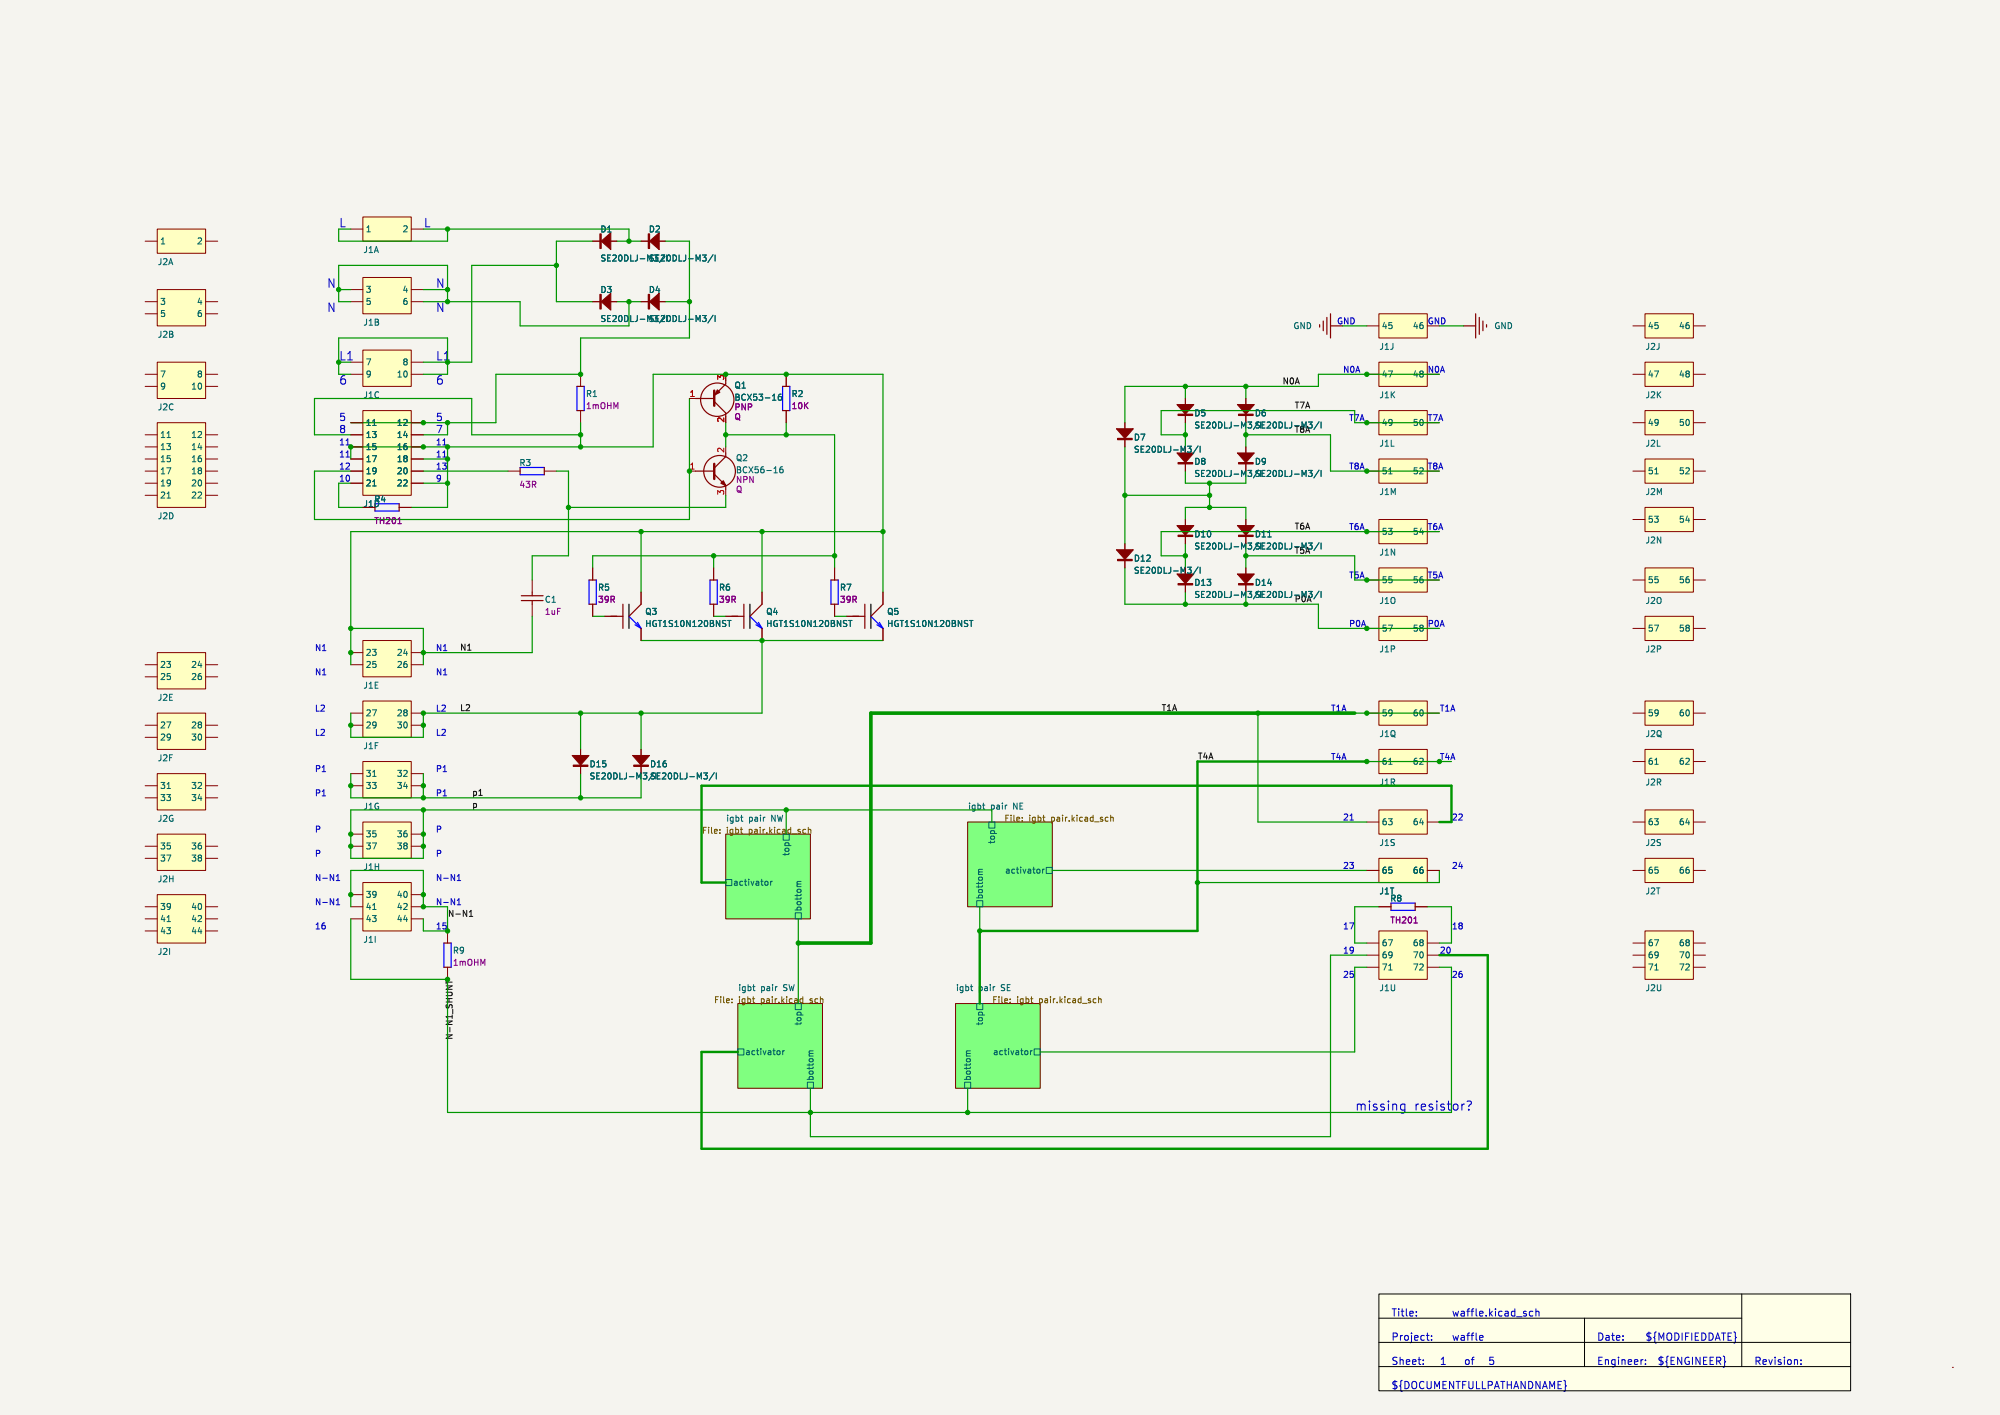
[picture p37: page 1]

igbt pair NW
File: igbt pair.kicad_sch top bottom

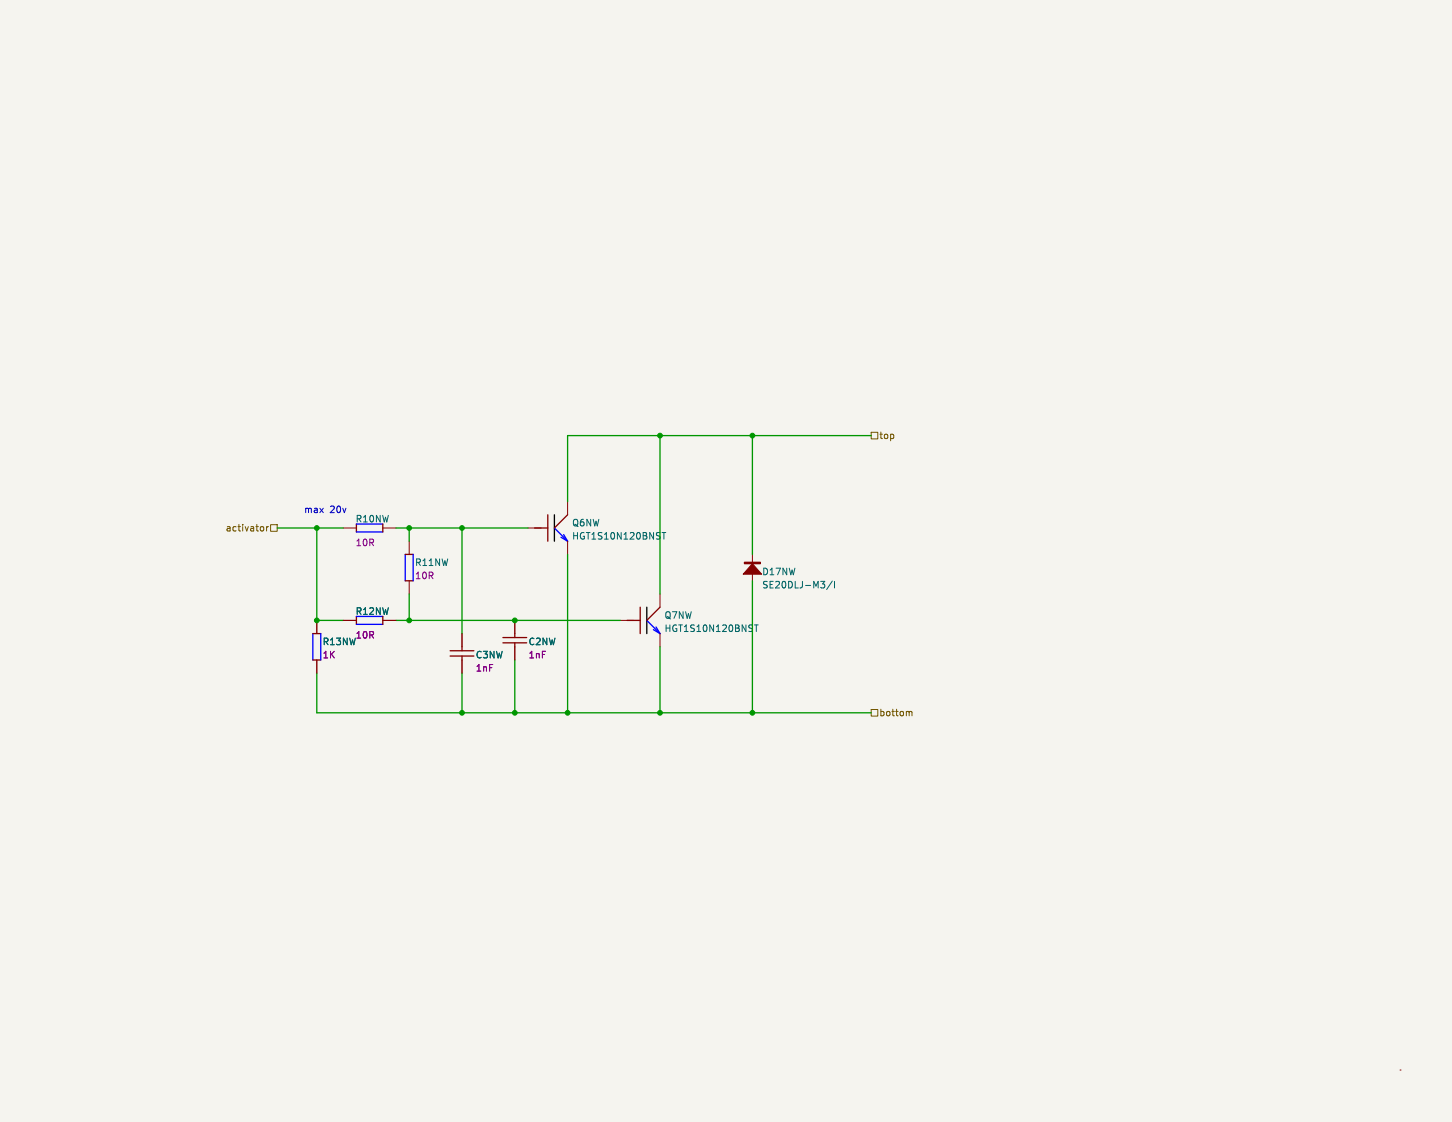
[picture p38: page 2]

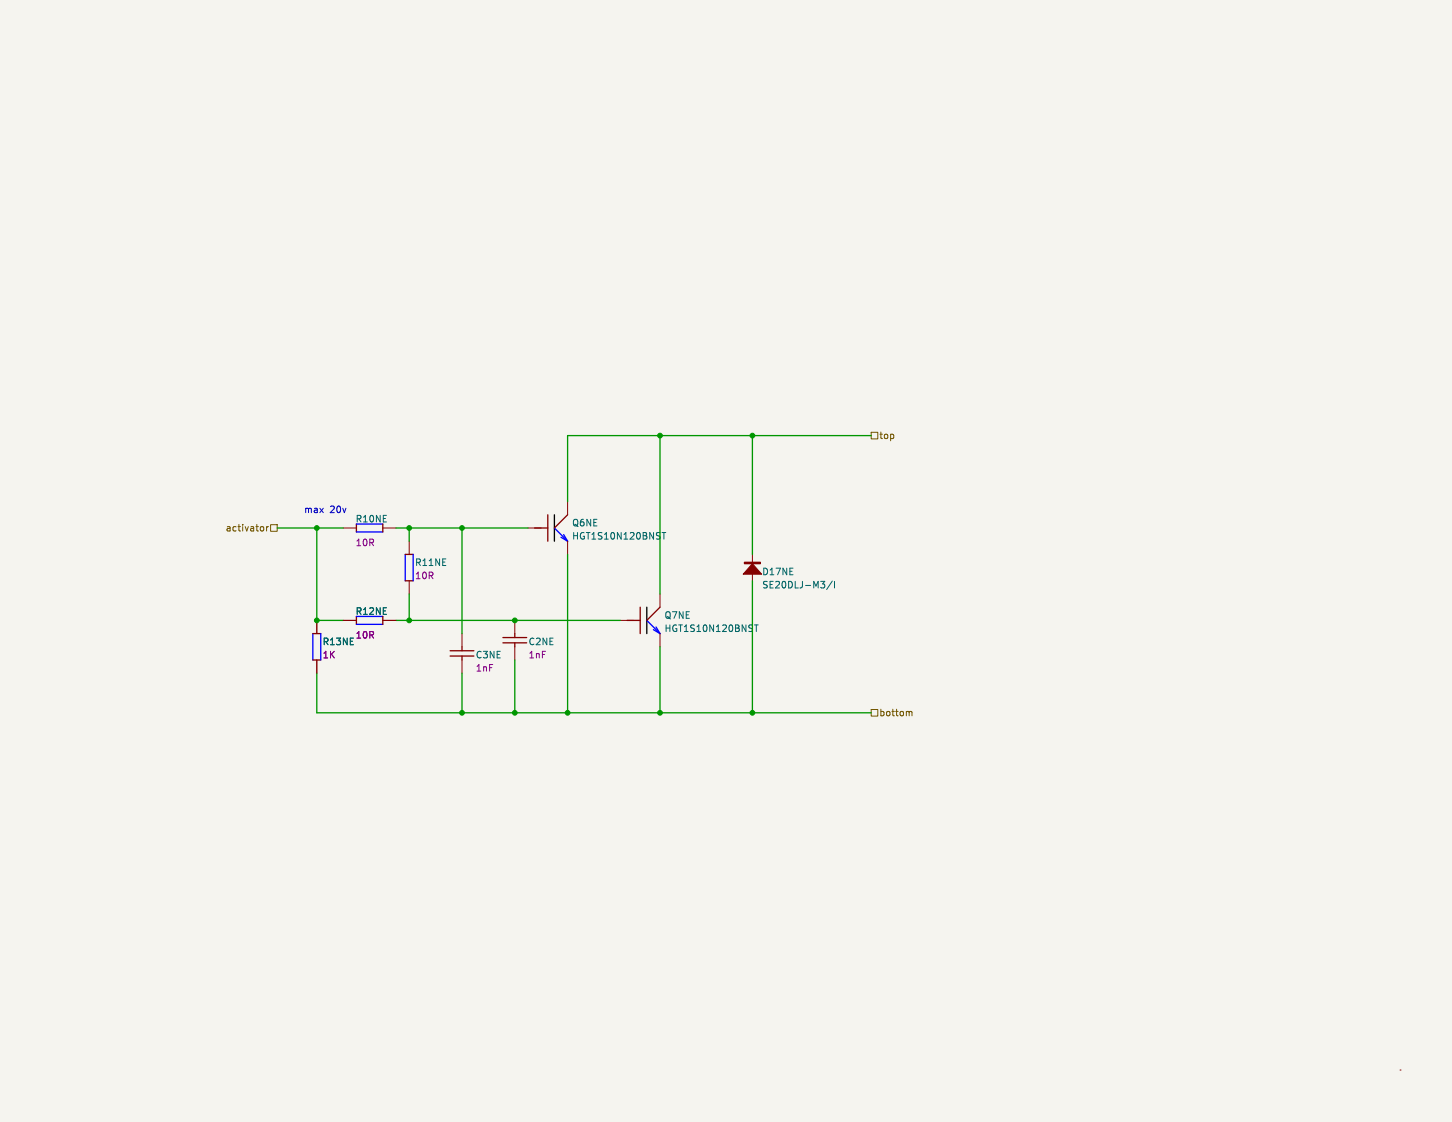
[picture p39: page 3]

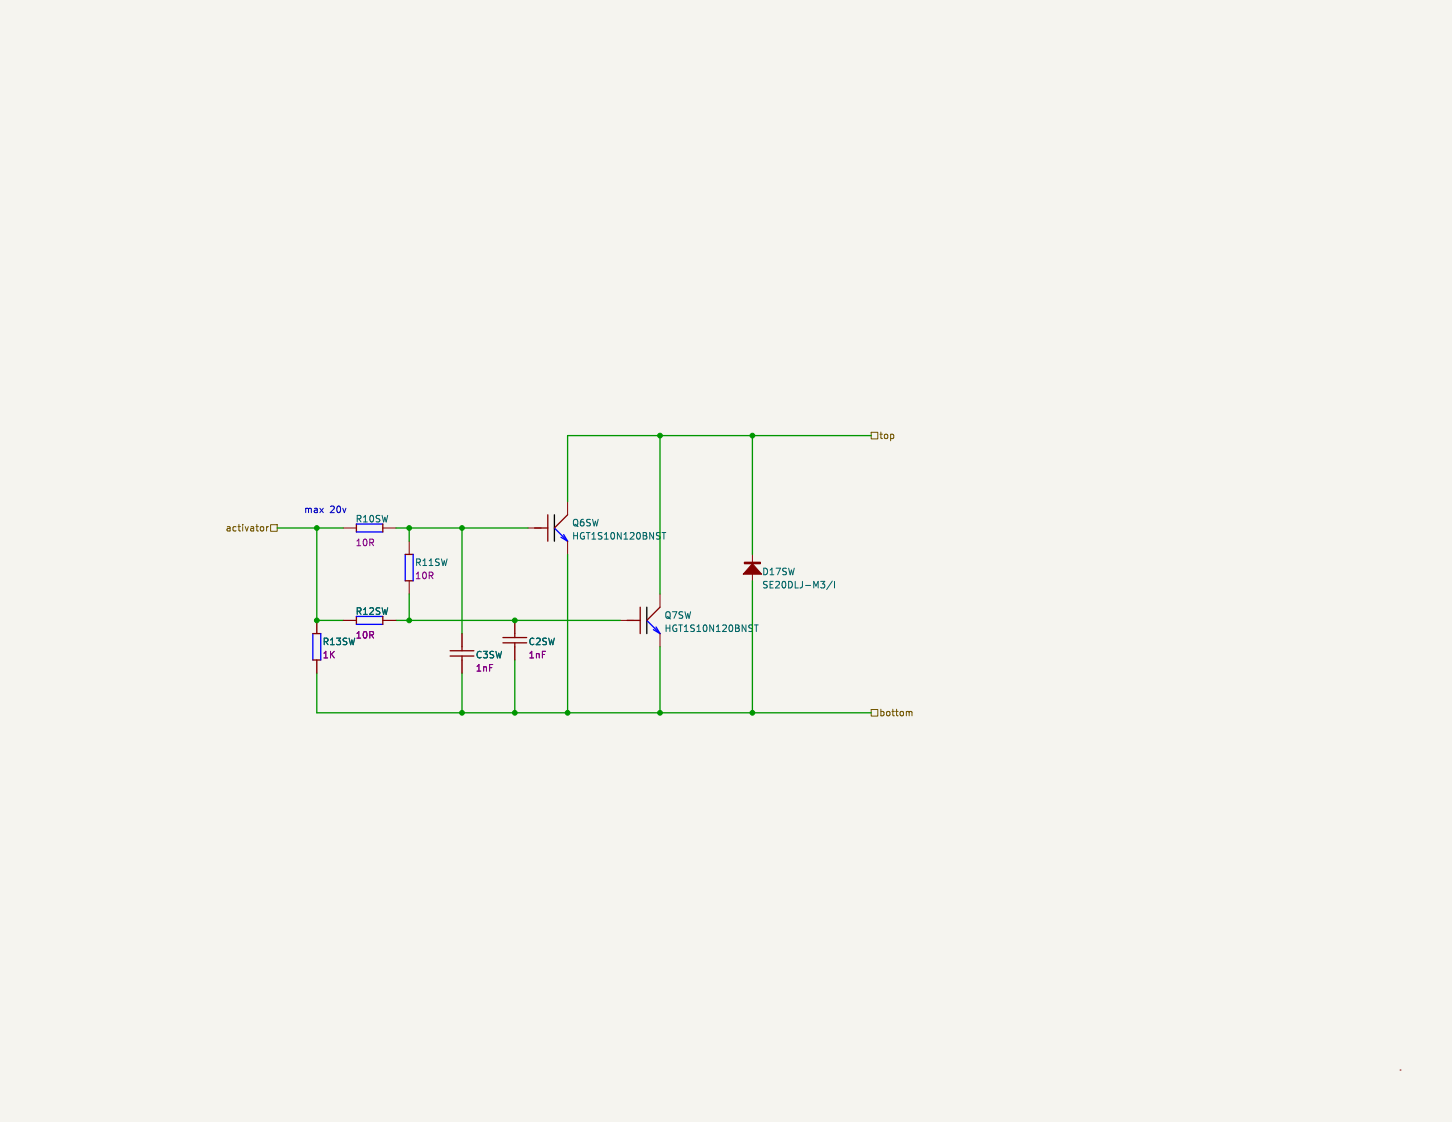
[picture p40: page 4]

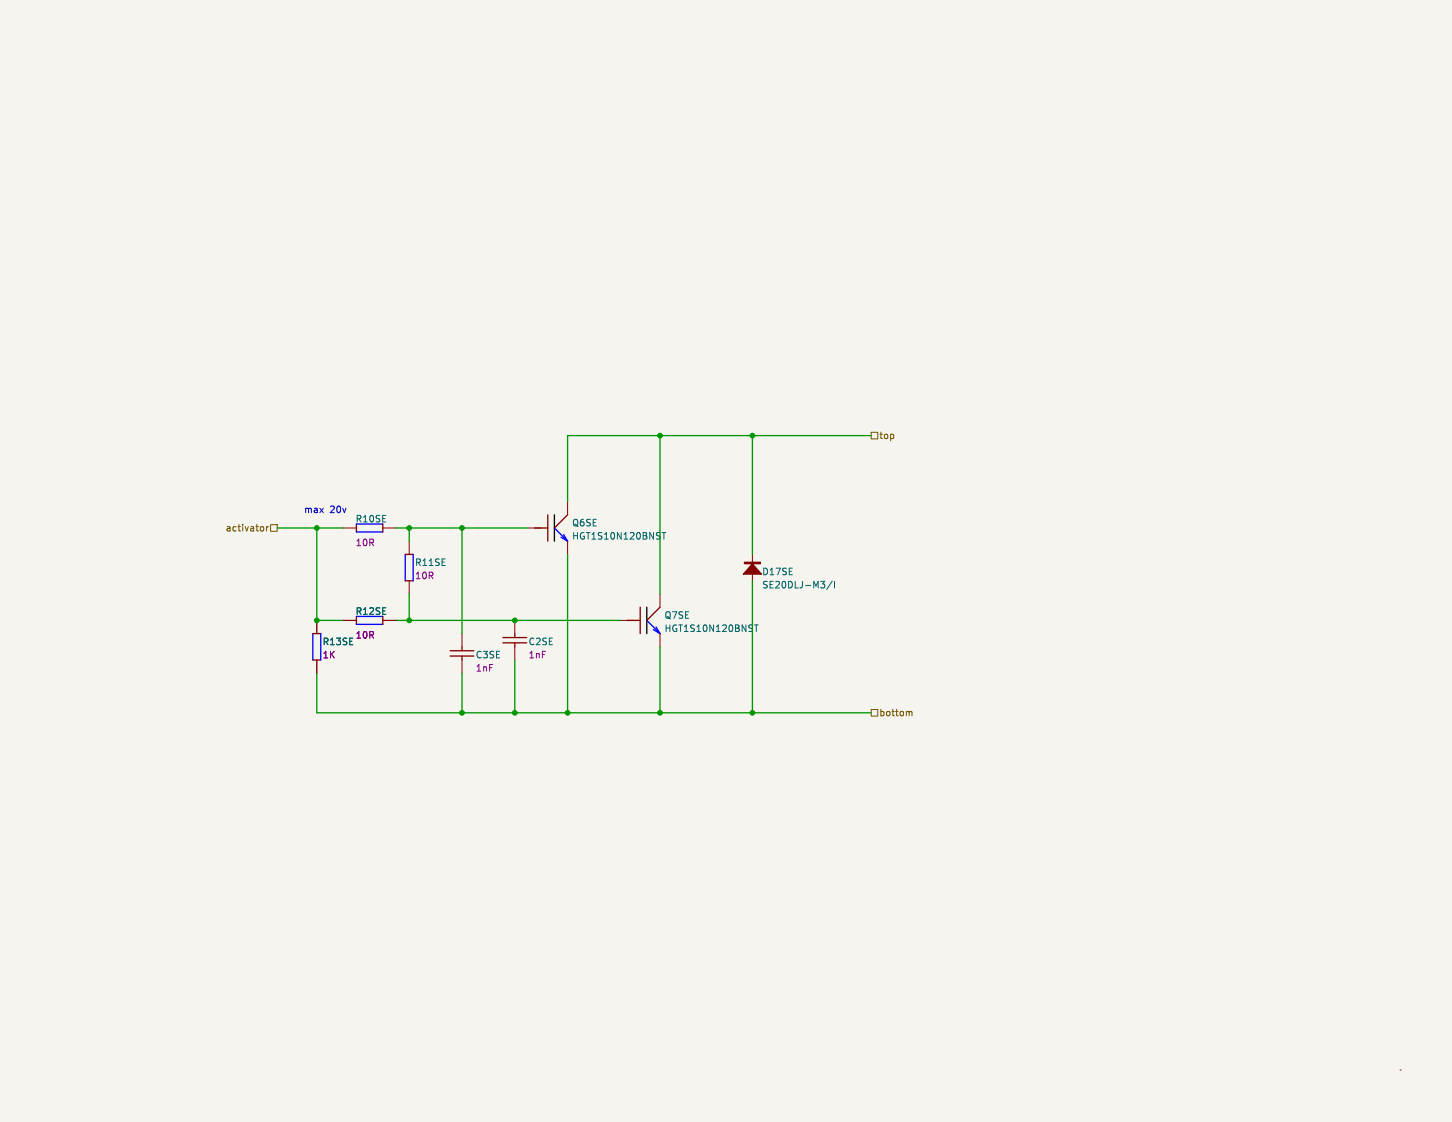
[picture p41: page 5]
