Mozzie-AU/LeafOBC-WafflePlate/(list of files, drawings)

Other design files:
hardware/replica-altium/altium/igbt pair.SchDoc
hardware/replica-altium/altium/Nissan Leaf Waffle.PrjPcb
hardware/replica-altium/altium/Nissan Leaf Waffle.SCHLIB
hardware/replica-altium/altium/waffle.PcbDoc
hardware/replica-altium/altium/waffle.PcbLib
hardware/replica-altium/altium/waffle.SchDoc
