Mozzie-AU/LeafOBC-WafflePlate/hardware/replica-altium/kicad/waffle.kicad_pcb

## KiCad design hardware/replica-altium/kicad/waffle.kicad_pcb (2026-10-25)

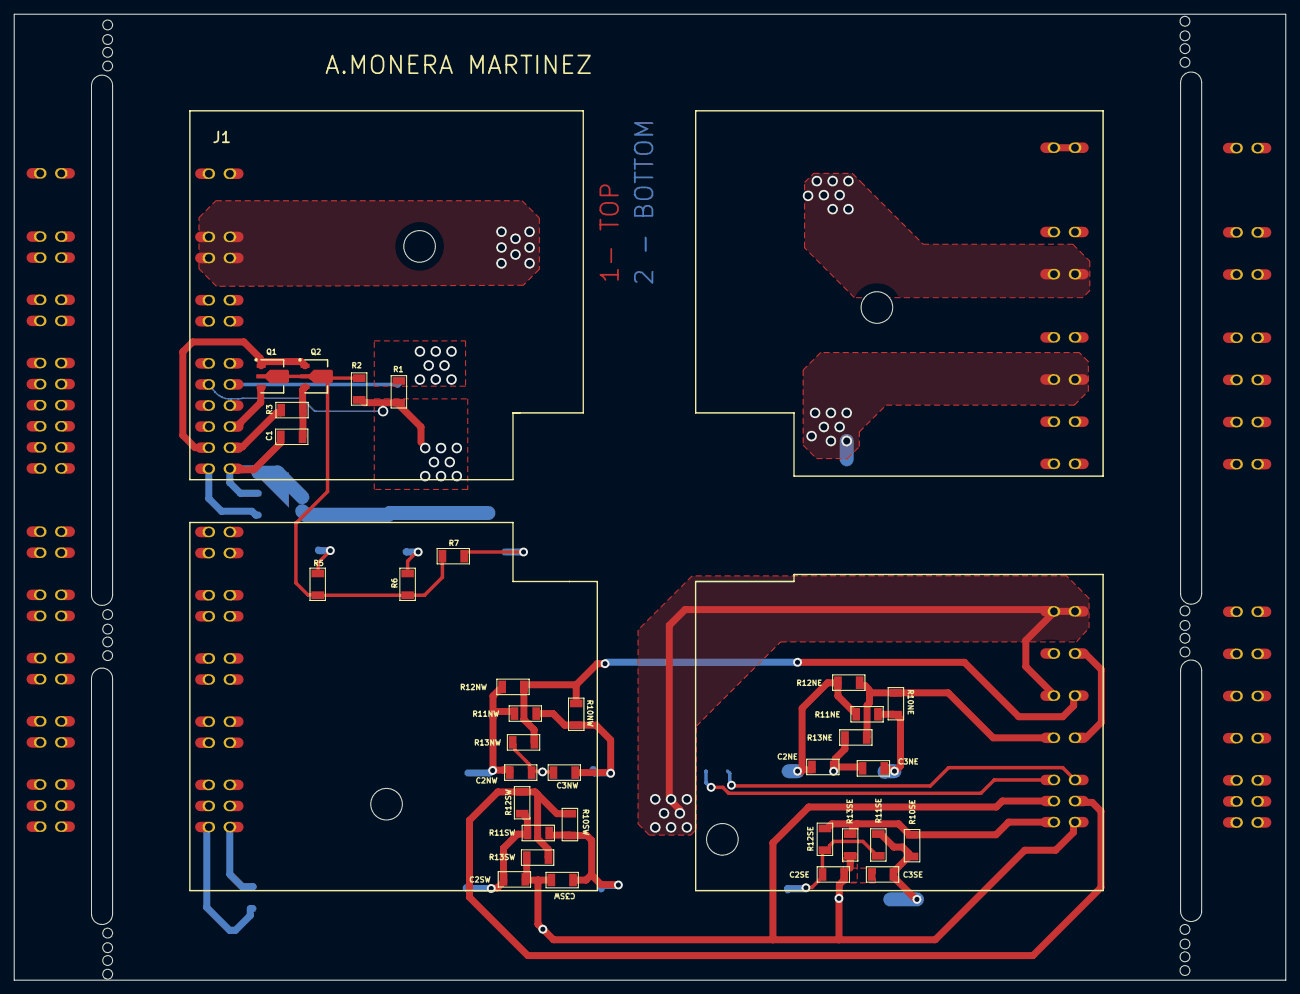
[picture p42: board waffle.kicad_pcb from above]

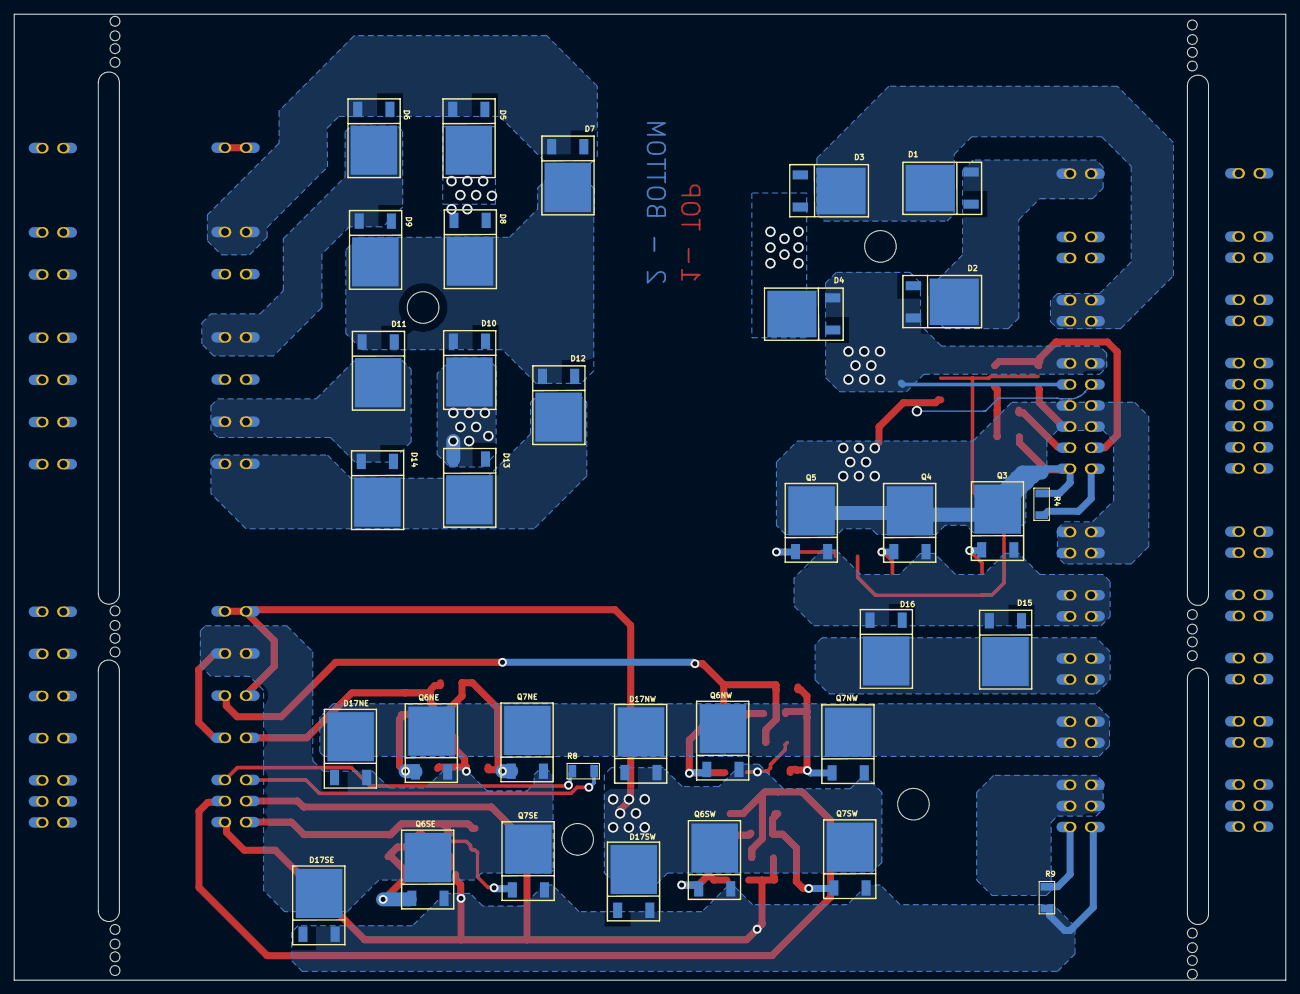
[picture p43: board waffle.kicad_pcb from below]

Board: 2 copper layers, 181.0 x 137.5 mm, 68 parts (34 on the bottom side), 42 nets.

Parts:
C1: 1uf; 1206
C2NE, C2NW, C2SE, C2SW, C3NE, C3NW, C3SE, C3SW: 1nF; 1206
D1, D2, D3, D4, D5, D6, D7, D8, D9, D10, D11, D12, D13, D14, D15, D16, D17NE, D17NW, D17SE, D17SW: SE20DLJ-M3/I; PG-TO252-3 - DIODE
J1: connector_waffle; WAFFLE
Q1: BCX53-16; SOT-89
Q2: BCX56-16; SOT-89
Q3, Q4, Q5, Q6NE, Q6NW, Q6SE, Q6SW, Q7NE, Q7NW, Q7SE, Q7SW: HGT1S10N120BNST; PG-TO252-3
R1, R9: 1mOHM; 1206
R2: 10K; 1206
R3: 43R; 1206
R4, R8: NB20N50104JBA; 1206
R5, R6, R7: 39R; 1206
R10NE, R10NW, R10SE, R10SW, R11NE, R11NW, R11SE, R11SW, R12NE, R12NW, R12SE, R12SW: 10R; 1206
R13NE, R13NW, R13SE, R13SW: 1K; 1206

Connections:
GND: J1.45, J1.46
L2: D15.A, D16.A, J1.27, J1.28, J1.29, J1.30, Q3.2, Q4.2, Q5.2
N0A: D5.A, D6.A, D7.A, J1.47, J1.48
N1: C1.2, J1.13, J1.15, J1.16, J1.17, J1.18, J1.22, J1.23, J1.24, J1.25, J1.26, Q1.3, Q3.3, Q4.3, Q5.3, R1.1, R2.2, R4.2
N-N1: J1.39, J1.40, J1.41, J1.42, J1.44, R9.2
N-N1_SHUNT: C2SE.2, C2SW.2, C3SE.2, C3SW.2, D17SE.A, D17SW.A, J1.43, J1.69, J1.72, Q6SE.2, Q6SW.2, Q7SE.2, Q7SW.2, R9.1, R13SE.1, R13SW.1
NetC1_1: C1.1, Q2.3, R3.2
NetC2NE_1: C2NE.1, Q7NE.1, R11NE.1, R12NE.2
NetC2NW_1: C2NW.1, Q7NW.1, R11NW.1, R12NW.2
NetC2SE_1: C2SE.1, Q7SE.1, R11SE.1, R12SE.2
NetC2SW_1: C2SW.1, Q7SW.1, R11SW.1, R12SW.2
NetC3NE_1: C3NE.1, Q6NE.1, R10NE.2, R11NE.2
NetC3NW_1: C3NW.1, Q6NW.1, R10NW.2, R11NW.2
NetC3SE_1: C3SE.1, Q6SE.1, R10SE.2, R11SE.2
NetC3SW_1: C3SW.1, Q6SW.1, R10SW.2, R11SW.2
NetD1_A: D1.A, D2.K, J1.1, J1.2
NetD1_K: D1.K, D3.K, J1.7, J1.8, J1.9, J1.10
NetD2_A: D2.A, D4.A, J1.11, J1.12, J1.14, R1.2
NetD3_A: D3.A, D4.K, J1.3, J1.4, J1.5, J1.6
NetD7_K: D7.K, D8.K, D9.K, D10.A, D11.A, D12.A
NetJ1_19: J1.19, Q1.1, Q2.1
NetJ1_20: J1.20, R3.1
NetJ1_21: J1.21, R4.1
NetJ1_64: J1.64, R10NW.1, R12NW.1, R13NW.2
NetJ1_65: J1.65, R10NE.1, R12NE.1, R13NE.2
NetJ1_67: J1.67, R8.1
NetJ1_68: J1.68, R8.2
NetJ1_70: J1.70, R10SW.1, R12SW.1, R13SW.2
NetJ1_71: J1.71, R10SE.1, R12SE.1, R13SE.2
NetQ1_2: Q1.2, Q2.2, R2.1, R5.2, R6.2, R7.2
NetQ3_1: Q3.1, R5.1
NetQ4_1: Q4.1, R6.1
NetQ5_1: Q5.1, R7.1
P0A: D12.K, D13.K, D14.K, J1.57, J1.58
T1A: C2NW.2, C3NW.2, D17NW.A, D17SW.K, J1.59, J1.60, J1.63, Q6NW.2, Q6SW.3, Q7NW.2, Q7SW.3, R13NW.1
T4A: C2NE.2, C3NE.2, D17NE.A, D17SE.K, J1.61, J1.62, J1.66, Q6NE.2, Q6SE.3, Q7NE.2, Q7SE.3, R13NE.1
T5A: D11.K, D14.A, J1.55, J1.56
T6A: D10.K, D13.A, J1.53, J1.54
T7A: D5.K, D8.A, J1.49, J1.50
T8A: D6.K, D9.A, J1.51, J1.52
p: D17NE.K, D17NW.K, J1.35, J1.36, J1.37, J1.38, Q6NE.3, Q6NW.3, Q7NE.3, Q7NW.3
p1: D15.K, D16.K, J1.31, J1.32, J1.33, J1.34
