Mozzie-AU/LeafOBC-WafflePlate/hardware/original-module/waffle-plate.kicad_sch

## KiCad design hardware/original-module/waffle-plate.kicad_sch (2026-11-02)

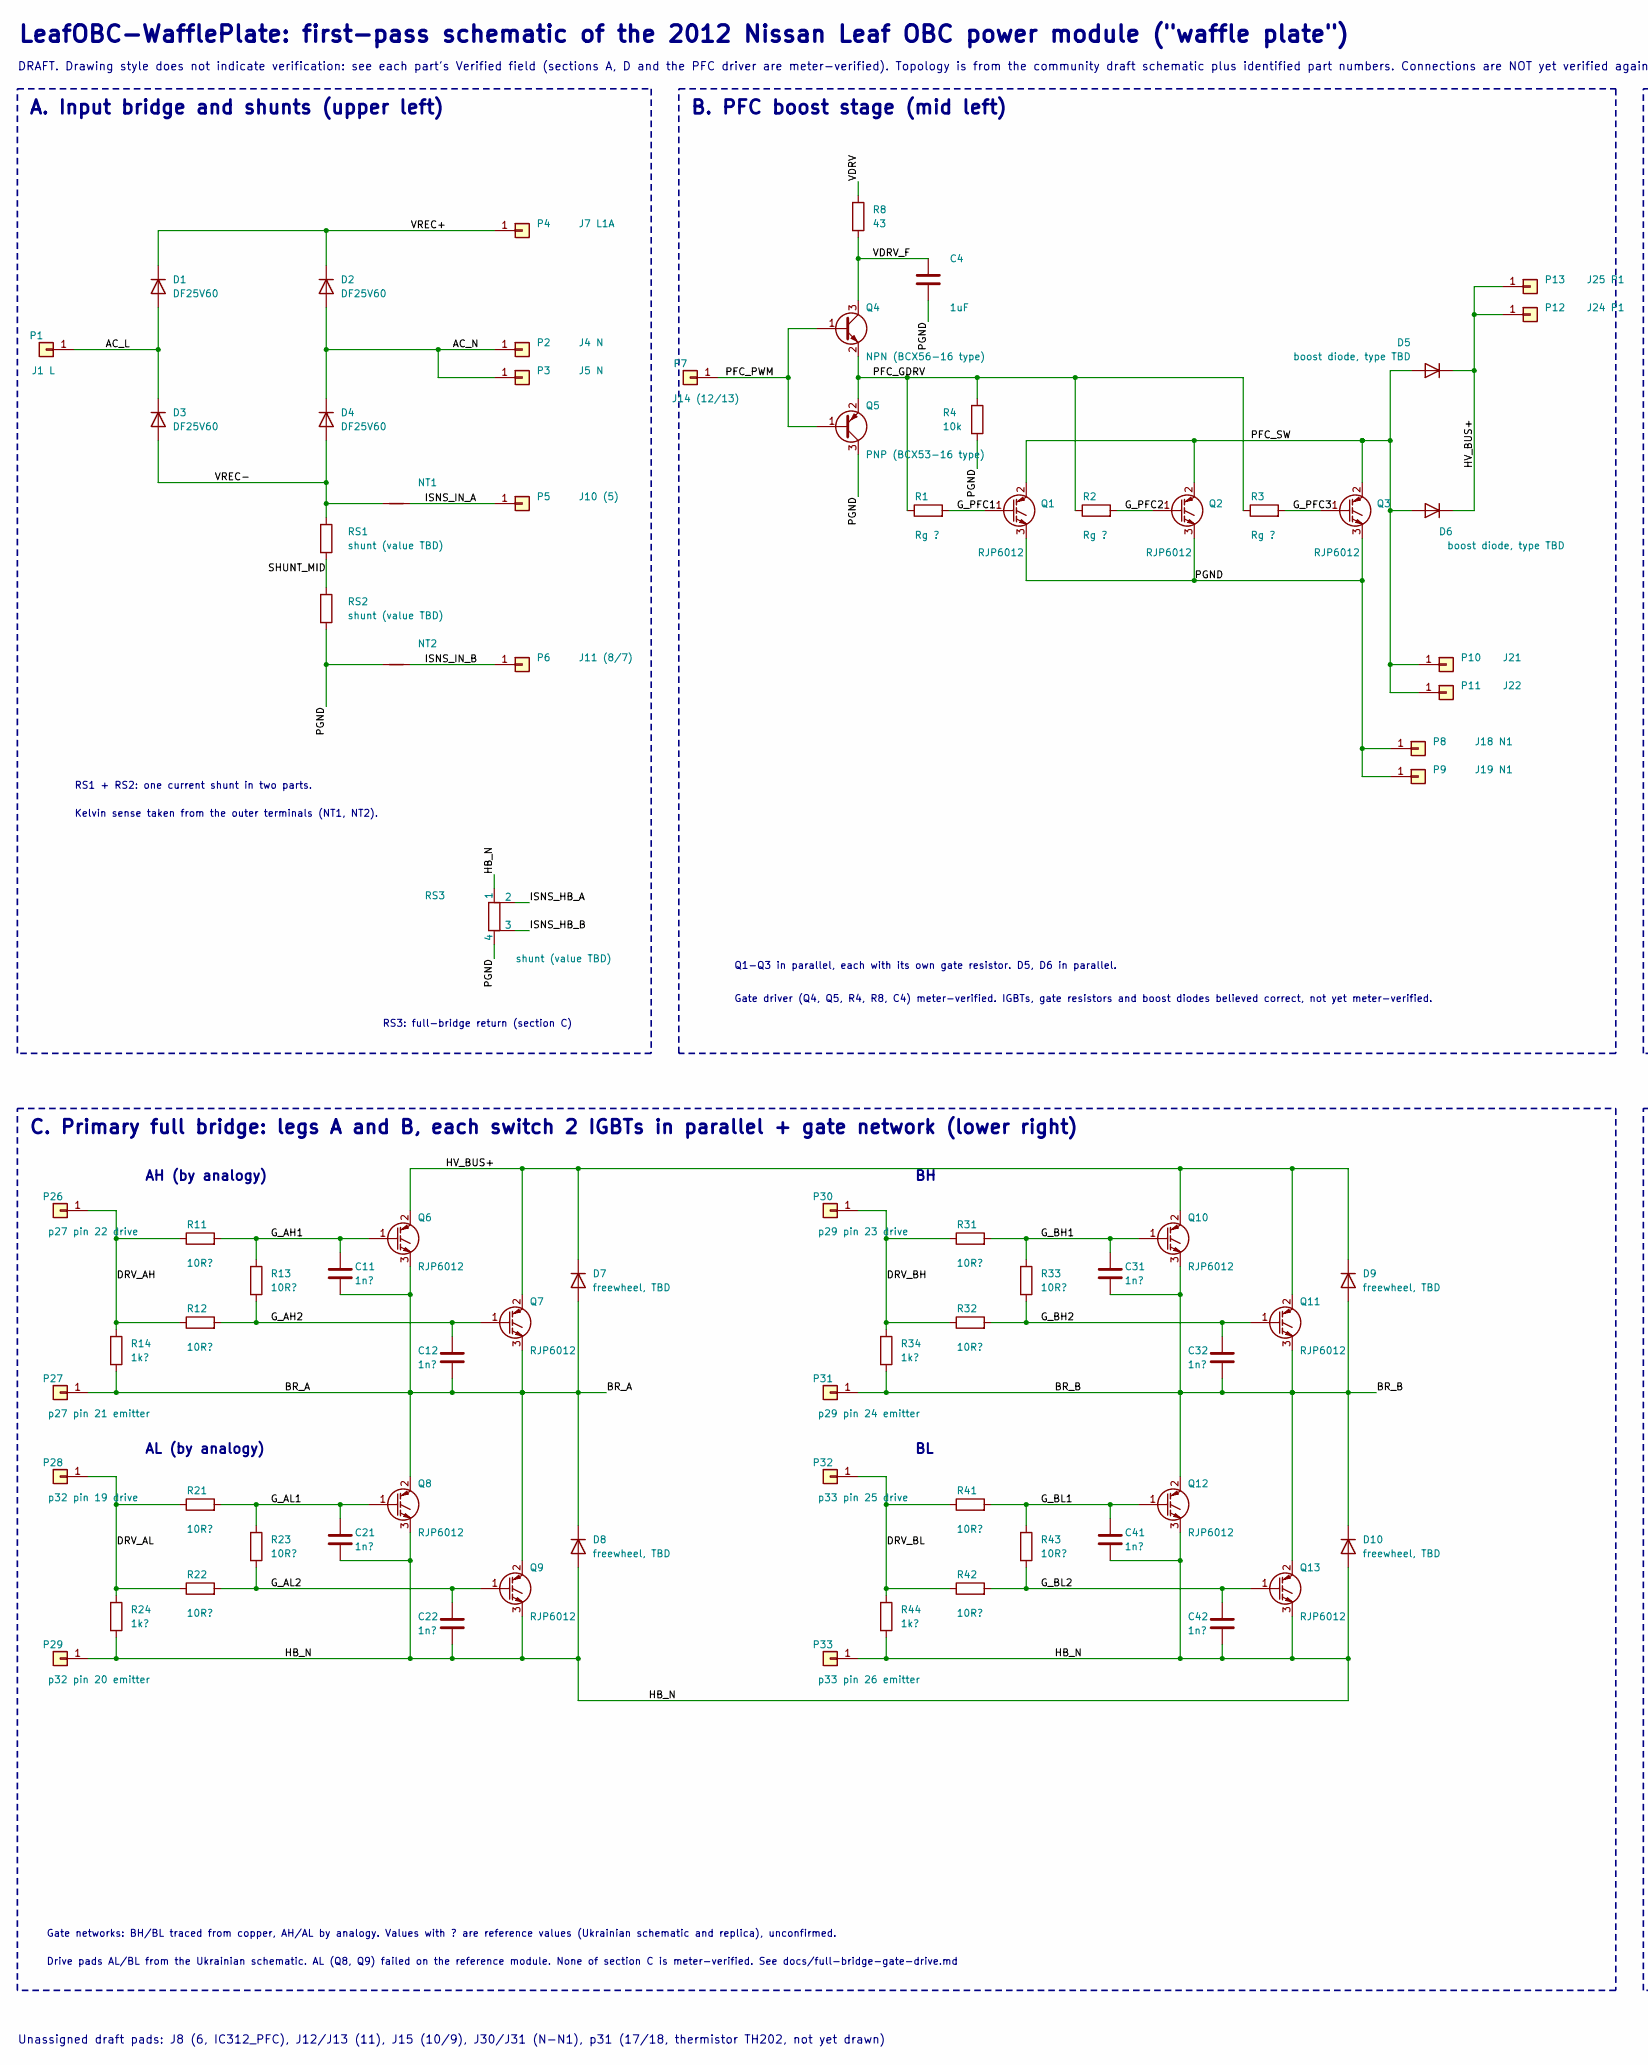
[picture p44: schematic waffle-plate.kicad_sch, part in row 1, column 1]

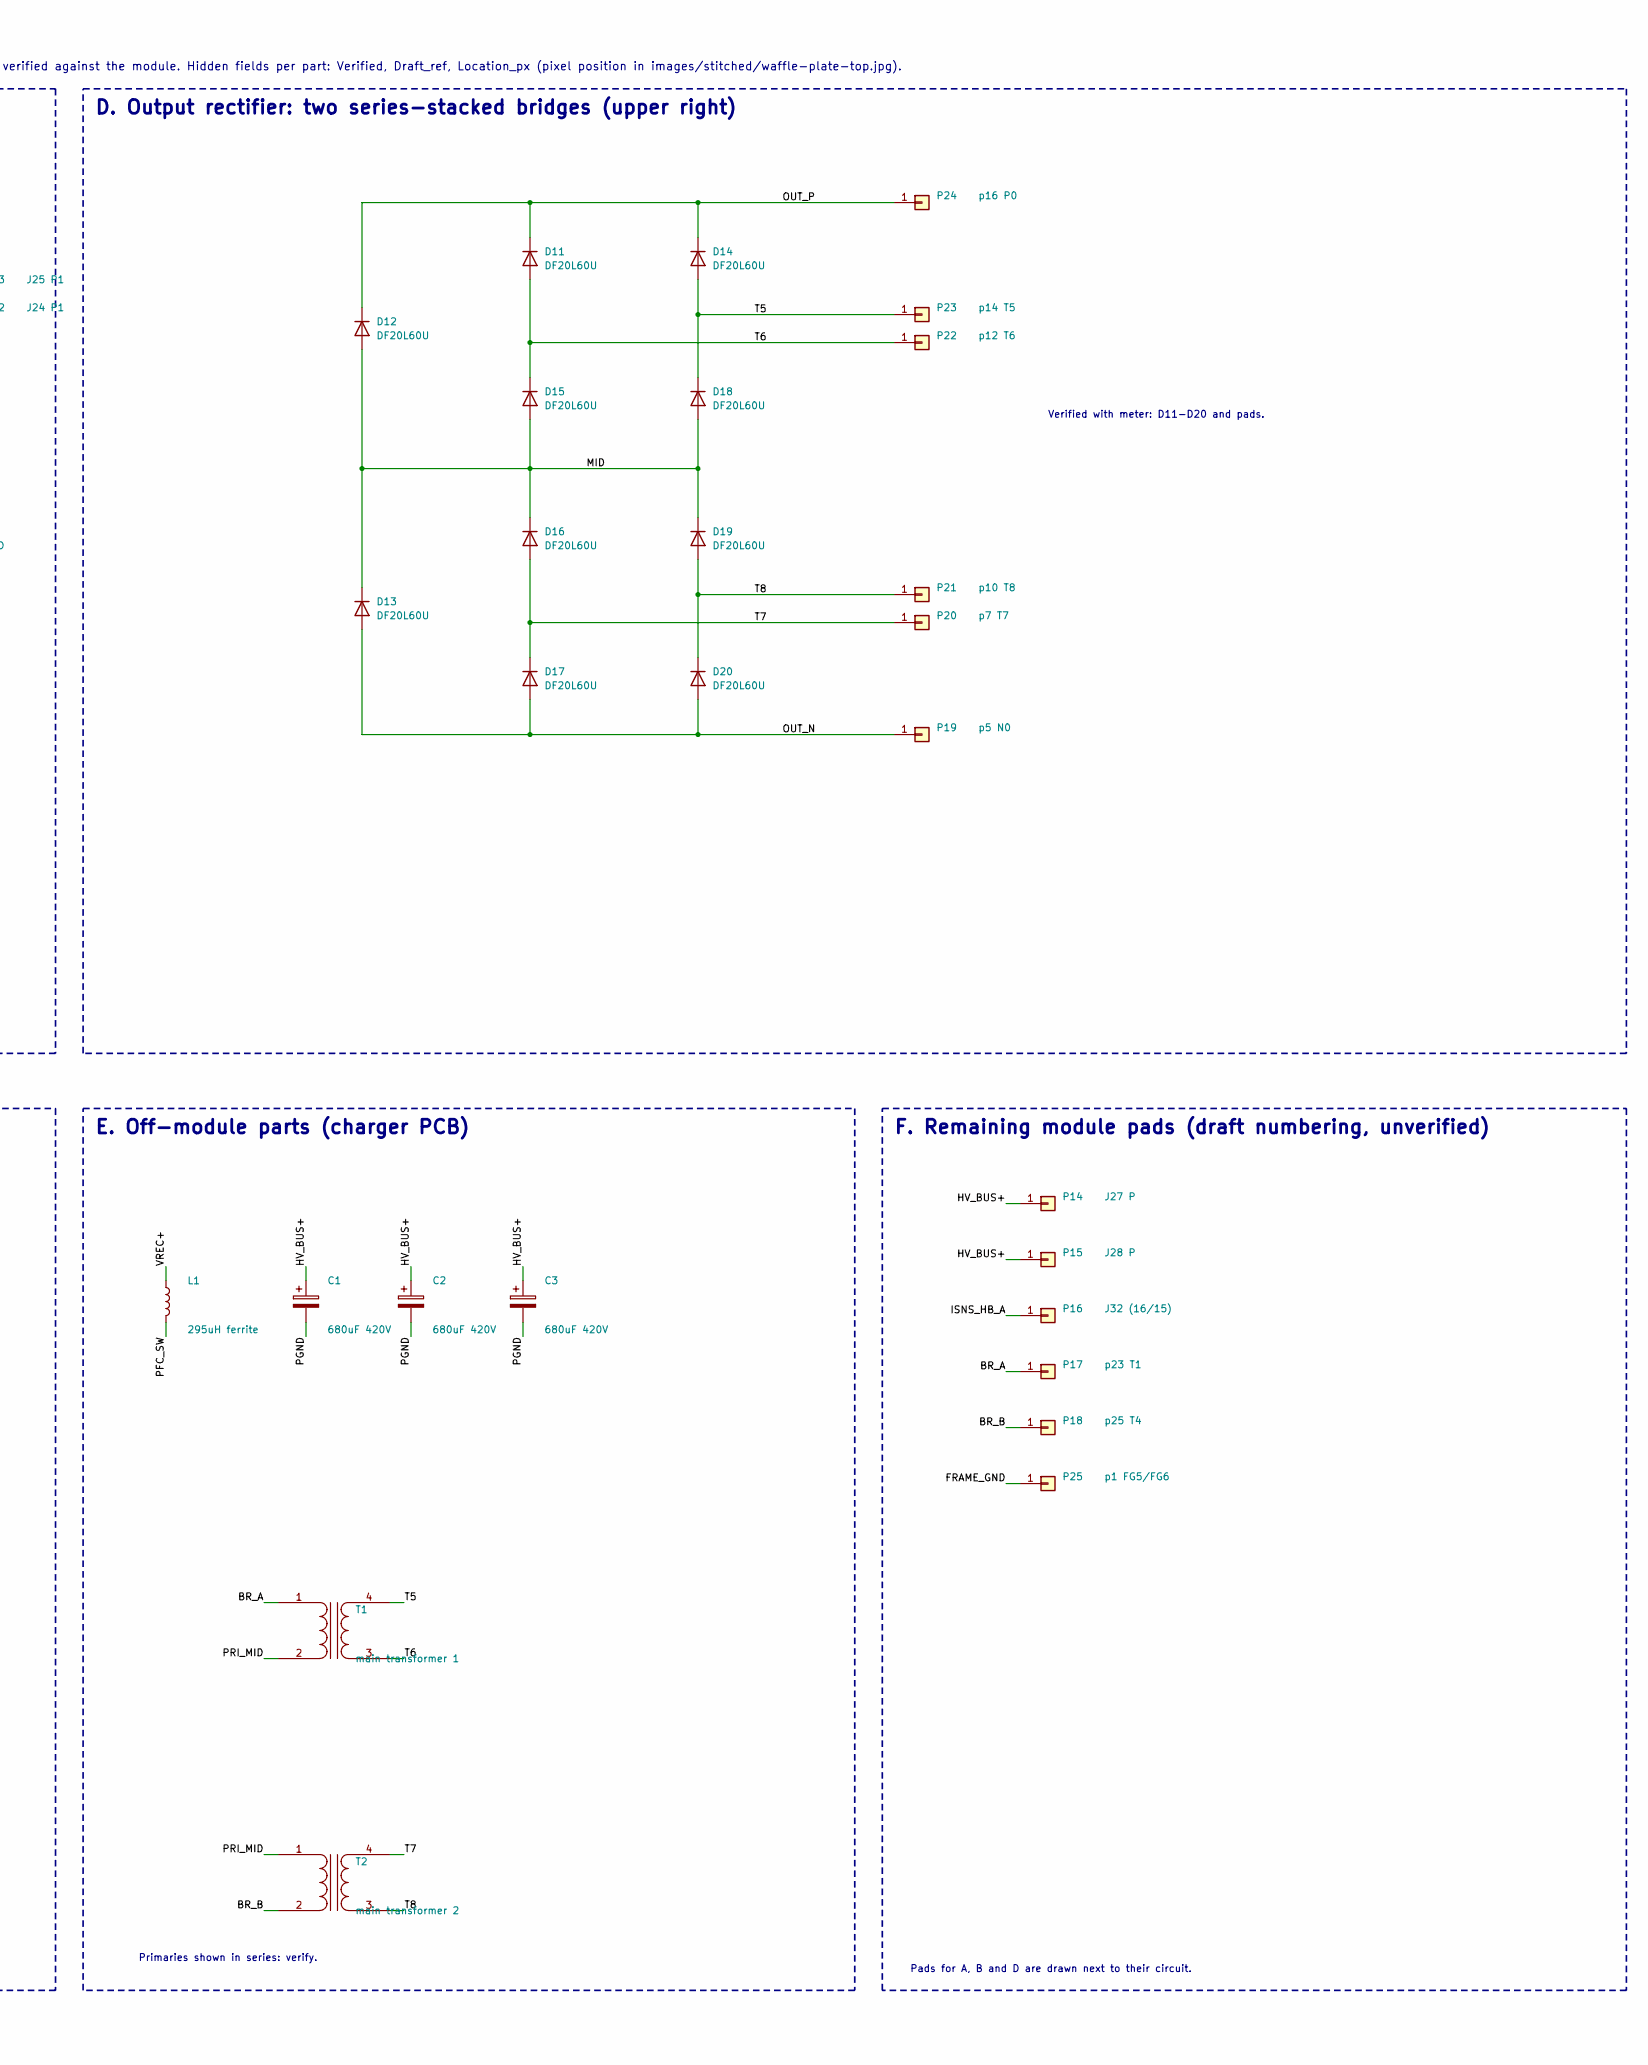
[picture p45: schematic waffle-plate.kicad_sch, part in row 1, column 2]

Parts:
C1, C2, C3: 680uF 420V
C4: 1uF
C11, C12, C21, C22, C31, C32, C41, C42: 1n?
D1, D2, D3, D4: DF25V60
D5, D6: boost diode, type TBD
D7, D8, D9, D10: freewheel, TBD
D11, D12, D13, D14, D15, D16, D17, D18, D19, D20: DF20L60U
L1: 295uH ferrite
NT1, NT2: Kelvin sense
P1: J1 L
P2: J4 N
P3: J5 N
P4: J7 L1A
P5: J10 (5)
P6: J11 (8/7)
P7: J14 (12/13)
P8: J18 N1
P9: J19 N1
P10: J21
P11: J22
P12: J24 P1
P13: J25 P1
P14: J27 P
P15: J28 P
P16: J32 (16/15)
P17: p23 T1
P18: p25 T4
P19: p5 N0
P20: p7 T7
P21: p10 T8
P22: p12 T6
P23: p14 T5
P24: p16 P0
P25: p1 FG5/FG6
P26: p27 pin 22 drive
P27: p27 pin 21 emitter
P28: p32 pin 19 drive
P29: p32 pin 20 emitter
P30: p29 pin 23 drive
P31: p29 pin 24 emitter
P32: p33 pin 25 drive
P33: p33 pin 26 emitter
Q1, Q2, Q3, Q6, Q7, Q8, Q9, Q10, Q11, Q12, Q13: RJP6012
Q4: NPN (BCX56-16 type)
Q5: PNP (BCX53-16 type)
R1, R2, R3: Rg ?
R4: 10k
R8: 43
R11, R12, R13, R21, R22, R23, R31, R32, R33, R41, R42, R43: 10R?
R14, R24, R34, R44: 1k?
RS1, RS2, RS3: shunt (value TBD)
T1: main transformer 1
T2: main transformer 2

Connections:
AC_L: D1.2 (A), D3.1 (K), P1.1
AC_N: D2.2 (A), D4.1 (K), P2.1, P3.1
BR_A: C11.2, C12.2, D7.2 (A), D8.1 (K), P17.1, P27.1, Q6.3 (E), Q7.3 (E), Q8.2 (C), Q9.2 (C), R14.2, T1.1 (AA)
BR_B: C31.2, C32.2, D9.2 (A), D10.1 (K), P18.1, P31.1, Q10.3 (E), Q11.3 (E), Q12.2 (C), Q13.2 (C), R34.2, T2.2 (AB)
DRV_AH: P26.1, R11.1, R12.1, R14.1
DRV_AL: P28.1, R21.1, R22.1, R24.1
DRV_BH: P30.1, R31.1, R32.1, R34.1
DRV_BL: P32.1, R41.1, R42.1, R44.1
FRAME_GND: P25.1
G_AH1: C11.1, Q6.1 (G), R11.2, R13.1
G_AH2: C12.1, Q7.1 (G), R12.2, R13.2
G_AL1: C21.1, Q8.1 (G), R21.2, R23.1
G_AL2: C22.1, Q9.1 (G), R22.2, R23.2
G_BH1: C31.1, Q10.1 (G), R31.2, R33.1
G_BH2: C32.1, Q11.1 (G), R32.2, R33.2
G_BL1: C41.1, Q12.1 (G), R41.2, R43.1
G_BL2: C42.1, Q13.1 (G), R42.2, R43.2
G_PFC1: Q1.1 (G), R1.2
G_PFC2: Q2.1 (G), R2.2
G_PFC3: Q3.1 (G), R3.2
HB_N: C21.2, C22.2, C41.2, C42.2, D8.2 (A), D10.2 (A), P29.1, P33.1, Q8.3 (E), Q9.3 (E), Q12.3 (E), Q13.3 (E), R24.2, R44.2, RS3.1
HV_BUS+: C1.1, C2.1, C3.1, D5.1 (K), D6.1 (K), D7.1 (K), D9.1 (K), P12.1, P13.1, P14.1, P15.1, Q6.2 (C), Q7.2 (C), Q10.2 (C), Q11.2 (C)
ISNS_HB_A: P16.1, RS3.2
ISNS_HB_B: RS3.3
ISNS_IN_A: NT1.2, P5.1
ISNS_IN_B: NT2.2, P6.1
MID: D12.2 (A), D13.1 (K), D15.2 (A), D16.1 (K), D18.2 (A), D19.1 (K)
OUT_N: D13.2 (A), D17.2 (A), D20.2 (A), P19.1
OUT_P: D11.1 (K), D12.1 (K), D14.1 (K), P24.1
PFC_GDRV: Q4.2 (E), Q5.2 (E), R1.1, R2.1, R3.1, R4.1
PFC_PWM: P7.1, Q4.1 (B), Q5.1 (B)
PFC_SW: D5.2 (A), D6.2 (A), L1.2, P10.1, P11.1, Q1.2 (C), Q2.2 (C), Q3.2 (C)
PGND: C1.2, C2.2, C3.2, C4.2, NT2.1, P8.1, P9.1, Q1.3 (E), Q2.3 (E), Q3.3 (E), Q5.3 (C), R4.2, RS2.2, RS3.4
PRI_MID: T1.2 (AB), T2.1 (AA)
SHUNT_MID: RS1.2, RS2.1
T5: D14.2 (A), D18.1 (K), P23.1, T1.4 (SB)
T6: D11.2 (A), D15.1 (K), P22.1, T1.3 (SA)
T7: D16.2 (A), D17.1 (K), P20.1, T2.4 (SB)
T8: D19.2 (A), D20.1 (K), P21.1, T2.3 (SA)
VDRV: R8.1
VDRV_F: C4.1, Q4.3 (C), R8.2
VREC+: D1.1 (K), D2.1 (K), L1.1, P4.1
VREC-: D3.2 (A), D4.2 (A), NT1.1, RS1.1

Notes on the sheet:
A. Input bridge and shunts (upper left)
RS3: full-bridge return (section C)
RS1 + RS2: one current shunt in two parts.
Kelvin sense taken from the outer terminals (NT1, NT2).
B. PFC boost stage (mid left)
Q1-Q3 in parallel, each with its own gate resistor. D5, D6 in parallel.
Gate driver (Q4, Q5, R4, R8, C4) meter-verified. IGBTs, gate resistors and boost diodes believed correct, not yet meter-verified.
D. Output rectifier: two series-stacked bridges (upper right)
Verified with meter: D11-D20 and pads.
C. Primary full bridge: legs A and B, each switch 2 IGBTs in parallel + gate network (lower right)
AH (by analogy)
AL (by analogy)
Gate networks: BH/BL traced from copper, AH/AL by analogy. Values with ? are reference values (Ukrainian schematic and replica), unconfirmed.
Drive pads AL/BL from the Ukrainian schematic. AL (Q8, Q9) failed on the reference module. None of section C is meter-verified. See docs/full-bridge-gate-drive.md
E. Off-module parts (charger PCB)
Primaries shown in series: verify.
F. Remaining module pads (draft numbering, unverified)
Pads for A, B and D are drawn next to their circuit.
Unassigned draft pads: J8 (6, IC312_PFC), J12/J13 (11), J15 (10/9), J30/J31 (N-N1), p31 (17/18, thermistor TH202, not yet drawn)
LeafOBC-WafflePlate: first-pass schematic of the 2012 Nissan Leaf OBC power module ("waffle plate")
DRAFT. Drawing style does not indicate verification: see each part's Verified field (sections A, D and the PFC driver are meter-verified). Topology is from the community draft schematic plus identified part numbers. Connections are NOT yet verified against the module. Hidden fields per part: Verifi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
