Mozzie-AU/LeafOBC-WafflePlate/(commit log)

2026-10-19 Add first-pass KiCad schematic of the original module and component map
    Topology from the community draft plus identified parts (DF25V60, DF20L60U,
    RJP6012, shunts). All connections are unverified; see docs/schematic-notes.md.
    Claude-Session: https://claude.ai/code/session_01TS5rJ6m2KPqTRFySQXpeEh
    [waffle-plate.kicad_sch]
2026-10-19 Schematic: wire verified input bridge, input shunt and output rectifier
    RS1 and RS2 are one shunt in two series parts with Kelvin sense from the
    outer terminals (net ties NT1, NT2). RS3 stays unverified.
    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
    [waffle-plate.kicad_sch]
2026-10-19 Schematic: wire the PFC stage
    Gate driver totem pole, per-IGBT gate resistors, Q1-Q3 in parallel and
    boost diodes D5/D6, with pads J14, J18/J19, J21/J22 and J24/J25 drawn
    next to the circuit. Netlist unchanged; parts stay unverified pending a
    meter check.
    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
    [waffle-plate.kicad_sch]
2026-10-25 Add Angel Monera Martinez's Altium replica design (27 Oct 2024 version)
    The design files and fabrication outputs (Gerbers, drill, BOM, pick and
    place, DRC) for the board version sent to JLCPCB on 28 Oct 2024.
    Included with the author's permission.
    Original design: Angel Monera Martinez
    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
    [Bill of Materials-Nissan Leaf Waffle.xlsx, Nissan Leaf Waffle.PrjPcb, Nissan Leaf Waffle.SCHLIB, Pick Place for waffle.csv, igbt pair.SchDoc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]
2026-10-25 Replica design: 23 Nov 2024 version
    Enlarged IGBT and diode pads, which were too tight for the parts.
    PCB and footprint library only; the schematic is unchanged.
    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
    [waffle.PcbDoc, waffle.PcbLib]
2026-10-25 Replica design: 4 Dec 2024 version (author's final)
    Adds support PCBs with breakout tabs that hold the pins in line while
    they are soldered. Schematic and PCB updated.
    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
    [waffle.PcbDoc, waffle.SchDoc]
2026-10-25 Docs: replica build log, renders, references and credits
    - docs/replica-altium-notes.md: Angel Monera Martinez's build log, from
    his Google Doc, with his images. Forum photos linked rather than copied;
    personal contact details left out.
    - hardware/replica-altium/README.md: contents, version history, BOM and
    known inconsistencies, how to open the files.
    - docs/references.md: the Ukrainian CZ1525RPWR012 schematic (summarised,
    not copied) and forum threads.
    - README: contributors, layout and status.
    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
2026-10-25 Add KiCad conversion of the Altium replica design
    Schematic and PCB (4 Dec 2024 version) imported with KiCad 7.0.11's
    Altium importers. After import, the multichannel switch sheet was given
    its NE/NW/SE/SW sheet names and per-channel references so the four
    switches stay separate and match the PCB. Schematic and PCB connectivity
    were checked against each other pin by pin (219 pins, 42 nets, identical).
    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
    [igbt pair.kicad_sch, p204_SOT-89.stp, waffle.kicad_pcb, waffle.kicad_sch]
2026-10-25 Docs: PFC gate driver pin-out and replica wiring error
    New page docs/pfc-gate-driver.md with an annotated image of the two
    driver transistors on the original module. Both emitters go to the gate
    output (complementary emitter follower), which matches our schematic.
    The Altium replica and the Ukrainian schematic swap emitter and
    collector on both transistors; the page gives the fix. Linked from the
    README, the schematic notes and the replica README.
    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
2026-10-25 Schematic: verified PFC gate driver, add 43R, 1uF and 10k pull-down
    Meter checks confirm the emitter-follower wiring read from the image.
    Q4/Q5 marked verified; R8 (43R supply), C4 (1uF decoupling) and R4
    (10k gate pull-down) added and verified. Docs updated.
    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
    [waffle-plate.kicad_sch]
2026-10-25 Docs: full-bridge gate network, traced from the image
    New page docs/full-bridge-gate-drive.md and map
    images/annotated/full-bridge-gate-map.jpg. Switch/leg assignment read
    from the copper. The two right-hand switches are traced in full and match
    the Ukrainian schematic's six-part gate network (two gate resistors, a
    resistor between the gates, two gate-emitter capacitors, a drive-input
    pull-down). The left-hand switches are located, with roles by analogy.
    Meter checklist and the AL (Q8/Q9) burn damage recorded.
    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
2026-10-25 Schematic: add full-bridge gate networks (unconfirmed)
    Section C now has each switch's six-part gate network (Rg1, Rg2, Rgg,
    C1, C2, Rge) with separate drive-input and gate nets, using reference
    values marked '?'. BH/BL traced from copper; AH/AL by analogy. RS3 moved
    to section A for space. Docs: Angel's design matches the traced
    topology; values checked against stand-in datasheets (RJP60V0DPM,
    HGTG10N120BND); AL failure and gate-termination damage noted.
    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
    [waffle-plate.kicad_sch]
2026-11-02 Schematic: full-bridge gate-drive pads (unconfirmed)
    Drive and emitter (Kelvin) pads for each switch added to section C
    (P26-P33): AH p27 (22/21), BH p29 (23/24), AL p32 (19/20), BL p33
    (25/26). AH and BH rows are supported by tracks traced in the image; AL
    and BL follow the Ukrainian schematic (the image was inconclusive). The
    p31 row is thermistor TH202. New annotated image and docs section.
    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
    [waffle-plate.kicad_sch]
2026-11-02 Schematic: draw the full bridge fully wired
    Section C redrawn as a wired H-bridge: legs A and B with high side above
    low side, shared HV_BUS+ rail, BR_A/BR_B midpoints and a joined HB_N
    rail. Each switch's gate network is wired from its drive pad to both
    gates, with the emitter (Kelvin) pad on the emitter rail. Netlist
    identical to the previous label-based version. Drawing style no longer
    indicates verification; the Verified field does (notes updated).
    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
    [waffle-plate.kicad_sch]
